SasataniLab/wpt-devkit/hardware/kicad/WPT-RX/Project Outputs for WPT-01-RECEIVER/Figure PNG/WPT-02-RECEIVER-BOTTOM_2020-03-09.png

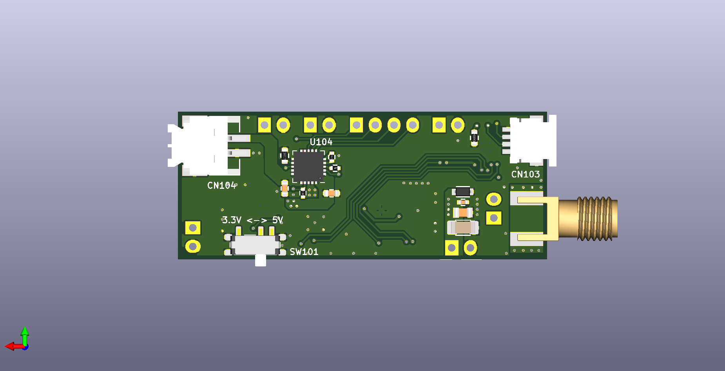
hardware/kicad/WPT-RX/Project Outputs for WPT-01-RECEIVER/Figure PNG/WPT-02-RECEIVER-BOTTOM_2020-03-09.png
