SasataniLab/wpt-devkit/hardware/kicad/WPT-RX/Project Outputs for WPT-01-RECEIVER/BOM/Bill of Materials - WPT-02-RECEIVER_2020-03-09.xlsx

Source: | E:\Dropbox\dev\prj\commissioned\University of Tokyo\WPT\electric\kicad\WPT-02-RECEIVER\WPT-02-RECEIVER.sch
Date: | 09/03/2020 07:57:30
Tool: | Eeschema (5.1.5)-3
Generator: | E:\Dropbox\dev\prj\kicad-library/bom_csv_grouped_by_value_with_fp.py
Component Count: | 84
Mount | Comment | Description | Designator | Footprint | Manufacturer | Manufacturer Part Number | Qnty | Qty for 25Units | Retailer
Yes | 0.022u/50(X7R) | CAP CER 0.022UF 50V X7R 0402 | C101, | murata:GRM15 | Murata Electronics | GRM155R71H223KA12D | 1 | 25
Yes | 10u/50(X5R) | CAP CER 10UF 50V X5R 1206 | C102, C107, | murata:GRM31 | Samsung Electro-Mechanics | CL31A106KBHNNNE | 2 | 50
Yes | 0.1u/50(X7R) | CAP CER 0.1UF 50V X7R 0402 | C103, C104, C116, C119, | murata:GRM15 | Murata Electronics | GCM155R71H104KE02D | 4 | 100
Yes | 1000p/50(C0G) | CAP CER 1000PF 50V 5% NP0 0402 | C105, | murata:GRM15 | Murata Electronics | GRM1555C1H102JA01D | 1 | 25
Yes | 0.1u/100(X7R) | CAP CER 0.1UF 100V X7R 0805 | C106, | murata:GRM21 | Murata Electronics | GCM21BR72A104KA37L | 1 | 25
Yes | 22u/16(X5R) | CAP CER 22UF 16V X5R 0805 | C108, C109, | murata:GRM21 | Samsung Electro-Mechanics | CL21A226MOCLRNC | 2 | 50
Yes | 10n/50(X7R) | CAP CER 10000PF 50V X7R 0402 | C110, | murata:GRM15 | Yageo | CC0402KRX7R9BB103 | 1 | 25
Yes | 10u/25(X5R) | CAP CER 10UF 25V 20% X5R 0603 | C111, | murata:GRM18 | Murata Electronics | GRM188R61E106MA73D | 1 | 25
Yes | 22u/10(X5R) | CAP CER 22UF 10V X5R 0603 | C112, C122, | murata:GRM18 | Murata Electronics | GRM188R61A226ME15D | 2 | 50
Yes | 68p/50(C0G) | CAP CER 68PF 50V C0G/NP0 0402 | C113, | murata:GRM15 | Murata Electronics | GCM1555C1H680JA16D | 1 | 25
Yes | 4.7u/16(X5R) | CAP CER 4.7UF 16V X5R 0603 | C117, C118, C120, | murata:GRM18 | Murata Electronics | GRM188R61C475KAAJD | 3 | 75
No | OPEN |  | C123, | murata:GRM18 |  |  | 1 | 25
No | CON-SMA-EDGE-S | CONN SMA JACK STR EDGE MNT | CN101, | RF_Solutions:CON-SMA-EDGE-S | RF Solutions | CON-SMA-EDGE-S | 1 | 25
No | ULO-PH409-1*2SF11 | CON HEADER 2 PIN THROUGHTHOLE 6.1/2.5/3mm HEIGHT | CN102, CN105, CN107, CN109, CN110, CN111, | ulo:ULO-PH409-1x2SX1 | ULO Electronic | ULO-PH409-1x2SX1 | 6 | 150
Yes | SM04B-SRSS-TB(LF)(SN) | CONN HEADER SH 4POS SIDE 1MM TIN | CN103, | Connectors_JST:SM04B-SRSS-TB | JST | SM04B-SRSS-TB(LF)(SN) | 1 | 25
Yes | S2B-PH-SM4-TB(LF)(SN) | CONN HEADER PH SIDE 2POS 2MM SMD | CN104, | Connectors_JST:S2B-PH-SM4-TB | JST | S2B-PH-SM4-TB(LF)(SN) | 1 | 25
No | ULO-PH409-1*4SF11 | CON HEADER 4 PIN THROUGHTHOLE 6.1/2.5/3mm HEIGHT | CN112, | ulo:ULO-PH409-1x4SX1 | ULO Electric | ULO-PH409-1*4SF11 | 1 | 25
Yes | PMEG6010AESBYL | DIODE SCHOTTKY 60V 1A DSN1006-2 | D101, D102, D105, D106, | Diodes_SMD:SOD-993_Nexperia | Nexperia | PMEG6010AESBYL | 4 | 100
Yes | S210FA | DIODE SCHOTTKY 100V 2A SOD123FA | D103, | Diodes_SMD:SOD-123FA_OnSemi | ON Semiconductor | S210FA | 1 | 25
Yes | MM3Z39VT1G | DIODE ZENER 39V 300MW SOD323 | D104, | Diodes_SMD:SOD-323 | ON Semiconductor | MM3Z39VT1G | 1 | 25
Yes | BLM18PG330SN1D | FERRITE CHIP 33 OHM 3000MA 0603 | FB101, FB102, | murata:BLM18 | Murata Electronics | BLM18PG330SN1D | 2 | 50
Yes | NR5040T4R7N | FIXED IND 4.7UH 3.1A 37.7 MOHM | L101, | taiyo-yuden:NR5040 | Taiyo Yuden | NR5040T4R7N | 1 | 25
Yes | DFE252012P-3R3M=P2 | FIXED IND 3.3UH 2.3A 140 MOHM | L102, | murata:DFE252012C | Murata Electronics | DFE252012P | 1 | 25
Yes | 82kF | RES SMD 82K OHM 1% 1/16W 0402 | R101, | yageo:R_0402 | Yageo | RC0402FR-0782KL | 1 | 25
Yes | 18kF | RES SMD 18K OHM 5% 1/16W 0402 | R102, | yageo:R_0402 | Yageo | RC0402FR-0718KL | 1 | 25
Yes | 27mF(1/4W) | RES 0.027 OHM 1% 1/4W 1206 3216Metric | R103, R107, | yageo:R_1206 | Yageo | RL1206FR-070R027L | 2 | 50
Yes | 10kF | RES SMD 10K OHM 1% 1/16W 0402 | R104, R116, | yageo:R_0402 | Yageo | RC0402FR-0710KL | 2 | 50
No | OPEN |  | R105, R106, R108, R114, R119, | yageo:R_0402 |  |  | 5 | 125
Yes | 750kF | RES SMD 750K OHM 1% 1/16W 0402 | R109, | yageo:R_0402 | Yageo | RC0402FR-07750KL | 1 | 25
Yes | 91kF | RES SMD 91K OHM 1% 1/16W 0402 | R110, | yageo:R_0402 | Yageo | RC0402FR-0791KL | 1 | 25
Yes | 820kF | RES SMD 820K OHM 1% 1/16W 0402 | R111, | yageo:R_0402 | Yageo | RC0402FR-07820KL | 1 | 25
Yes | 0 | RES SMD 0.0OHM JUMPER 1/16W 0402 | R113, R115, | yageo:R_0402 | Yageo | RC0402FR-070RL | 2 | 50
Yes | 0 | RES SMD 0.0OHM JUMPER 1/10W 0603 | R112, R117, | yageo:R_0603 | Yageo | RC0603FR-070RL | 2 | 50
Yes | NCP15XH103F03RC | THERMISTOR 10K OHM NTC 0402 SMD | R118, | murata:NTC_0402 | Murata Electronics | NCP15XH103F03RC | 1 | 25
Yes | 100kF | RES SMD 100K OHM 1% 1/16W 0402 | R120, R126, | yageo:R_0402 | Yageo | RC0402FR-07100KL | 2 | 50
Yes | 143kF | RES SMD 143K OHM 1% 1/16W 0402 | R121, | yageo:R_0402 | Yageo | RC0402FR-07143KL | 1 | 25
Yes | 100kF | RES SMD 100K OHM 1% 1/10W 0603 | R123, | yageo:R_0603 | Yageo | RC0603FR-07100KL | 1 | 25
Yes | 10kF | RES SMD 10K OHM 1% 1/10W 0603 | R124, | yageo:R_0603 | Yageo | RC0603FR-0710KL | 1 | 25
Yes | CUS-12TB | SWITCH SLIDE SPDT 300MA 4V | SW101, | Nidec_Copal_Electronics:CUS-12TB | Nidec Copal Electronics | CUS-12TB | 1 | 25
No | TP1.0 | TEST POINT 1mm | TP101, TP102, TP103, TP104, TP105, TP106, TP107, TP108, TP109, TP110, TP111, TP112, TP113, TP114, | TestPoint:TP_1mm |  |  | 14 | 350
Yes | TS30042-M000QFNR | IC REG BUCK ADJ 2A SYNC 16-VQFN | U101, | Housings_DFN_QFN:QFN-16-1EP_3x3mm_Pitch0.5mm_Semtech | Semtech | TS30042-M000QFNR | 1 | 25
Yes | MP2155GQ-Z | IC REG BCK BST 3.3V/ADJ 10QFN | U102, | Housings_DFN_QFN:DFN-10-1EP_3x3mm_Pitch0.5mm_MPS | Monolithic Power Systems Inc. | MP2155GQ-Z | 1 | 25
Yes | PAC1720-1-AIA-TR | IC CURRENT SENSE MON DUAL 10VDFN | U103, | Housings_DFN_QFN:DFN-10-1EP_3x3mm_Pitch0.5mm_microchip_9Q | microchip | PAC1720-1-AIA-TR | 1 | 25
Yes | MCP73871T-1CCI_ML | USB/AC BATTERY CHARGER 4.1V 6H Timer 3.1V LBO | U104, | Housings_DFN_QFN:QFN-20-1EP_4x4mm_Pitch0.5mm_microchip_ML | microchip | MCP73871T-1CCI/ML | 1 | 25
Yes | CG0402MLC-3.3LG | VARISTOR 3.3V 0402 | VD101, | bourns:CG0402 | Bourns Inc. | CG0402MLC-3.3LG | 1 | 25
