SasataniLab/wpt-devkit/hardware/kicad/WPT-TX/WPT-01-TRANSMITTER.csv

Reference | Qty | Value | DNP | Exclude from BOM | Exclude from Board | Exclude from Simulation | Exclude from Position Files | Footprint | Datasheet
C201,C202,C212,C218,C220,C222 | 6 | 10u/50(X7R) |  |  |  |  | ${EXCLUDE_FROM_POS_FILES} | murata:GRM31 | http://www.samsungsem.com/kr/support/product-search/mlcc/CL31A106KBHNNNE.jsp
C203,C204,C207,C208,C209,C210,C211,C301,C303,C311,C312,C317,C319,C321,C328,C329,C334 | 17 | 0.1u/50(X7R) |  |  |  |  | ${EXCLUDE_FROM_POS_FILES} | murata:GRM15 | http://www.murata.com/~/media/webrenewal/support/library/catalog/products/capacitor/mlcc/c02e.ashx,http://www.murata.com/~/media/webrenewal/support/library/ca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
C205,C206 | 2 | 0.022u/50(X7R) |  |  |  |  | ${EXCLUDE_FROM_POS_FILES} | murata:GRM15 | http://www.murata.com/~/media/webrenewal/support/library/catalog/products/capacitor/mlcc/c02e.ashx?la=en
C213,C214,C314,C335 | 4 | 1u/50(X7R) |  |  |  |  | ${EXCLUDE_FROM_POS_FILES} | murata:GRM21 | http://www.samsungsem.com/kr/support/product-search/mlcc/CL21B105KBFNNNG.jsp
C215,C216 | 2 | 10u/25(X5R) |  |  |  |  | ${EXCLUDE_FROM_POS_FILES} | murata:GRM18 | http://www.murata.com/~/media/webrenewal/support/library/catalog/products/capacitor/mlcc/c02e.ashx
C217,C219 | 2 | 22u/16(X5R) |  |  |  |  | ${EXCLUDE_FROM_POS_FILES} | murata:GRM21 | http://www.samsungsem.com/kr/support/product-search/mlcc/CL21B105KBFNNNG.jsp
C221,C223 | 2 | 10n/50(X7R) |  |  |  |  | ${EXCLUDE_FROM_POS_FILES} | murata:GRM15 | http://www.yageo.com/documents/recent/UPY-GPHC_X7R_6.3V-to-50V_18.pdf
C302,C304,C318,C320 | 4 | 22n/25(X7R) |  |  |  |  | ${EXCLUDE_FROM_POS_FILES} | murata:GRM15 | http://www.yageo.com/documents/recent/UPY-GPHC_X7R_6.3V-to-50V_18.pdf
C305,C306,C307,C308,C322,C323,C324,C325 | 8 | 10n/100(X7R) |  |  |  |  | ${EXCLUDE_FROM_POS_FILES} | murata:GRM18 | http://www.samsungsem.com/kr/support/product-search/mlcc/CL10B103KC8WPNC.jsp
C309,C310,C326,C327 | 4 | 2.2u/100(X7R) |  |  |  |  | ${EXCLUDE_FROM_POS_FILES} | murata:GRM32 | http://www.samsungsem.com/kr/support/product-search/mlcc/CL32B225KCJZW6E.jsp
C313,C331 | 2 | 4.7u/16(X5R) |  |  |  |  | ${EXCLUDE_FROM_POS_FILES} | murata:GRM15 | http://www.samsungsem.com/kr/support/library/product-catalog/mlcc.jsp
C315,C316,C336,C337 | 4 | 22p/50(C0G) |  |  |  |  | ${EXCLUDE_FROM_POS_FILES} | murata:GRM15 | http://www.murata.com/~/media/webrenewal/support/library/catalog/products/capacitor/mlcc/c02e.ashx
C330,C332,C333 | 3 | OPEN |  |  |  |  | ${EXCLUDE_FROM_POS_FILES} | murata:GRM15 | http://www.murata.com/~/media/webrenewal/support/library/catalog/products/capacitor/mlcc/c02e.ashx,http://www.yageo.com/documents/recent/UPY-GPHC_X7R_6.3V-to-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
CN201,CN202,CN204,CN205 | 4 | ULO-FH411-1*15SF11 |  |  |  |  | ${EXCLUDE_FROM_POS_FILES} | ulo:ULO-FH411-1x15SX1
CN203,CN207 | 2 | ULO-PH409-1*3SF11 |  |  |  |  | ${EXCLUDE_FROM_POS_FILES} | ulo:ULO-PH409-1x3SX1 | http://www.ulogroup.com/upload/2013101815053045.pdf
CN206 | 1 | SM04B-SRSS-TB(LF)(SN) |  |  |  |  | ${EXCLUDE_FROM_POS_FILES} | Connectors_JST:SM04B-SRSS-TB | http://www.jst-mfg.com/product/pdf/eng/eSH.pdf
CN208,CN209,CN210,CN302,J202 | 5 | ULO-PH409-1*2SF11 |  |  |  |  | ${EXCLUDE_FROM_POS_FILES} | ulo:ULO-PH409-1x2SX1 | http://www.ulogroup.com/upload/2013101815053045.pdf
CN301 | 1 | CON-SMA-EDGE-S |  |  |  |  | ${EXCLUDE_FROM_POS_FILES} | RF_Solutions:CON-SMA-EDGE-S | https://media.digikey.com/pdf/Data%20Sheets/RF%20Solutions%20PDFs/CON-SMA-EDGE.pdf
D201 | 1 | OSR5JA3Z74A |  |  |  |  | ${EXCLUDE_FROM_POS_FILES} | LED_THT:LED_D3.0mm | http://akizukidenshi.com/download/ds/optosupply/OSXXXX3Z74A_VER_A1.pdf
D202,D203 | 2 | S210FA |  |  |  |  | ${EXCLUDE_FROM_POS_FILES} | Diodes_SMD:SOD-123FA_OnSemi | https://www.onsemi.com/pub/Collateral/SS29FA-D.pdf
D301,D307 | 2 | MM3Z5V1T1G |  |  |  |  | ${EXCLUDE_FROM_POS_FILES} | SOD-323 | http://www.onsemi.com/pub/Collateral/MM3Z2V4T1-D.PDF
D302,D308 | 2 | BAT54KFILM |  |  |  |  | ${EXCLUDE_FROM_POS_FILES} | Diodes_SMD:SOD-523F_STMicroelectronics | http://www.st.com/content/ccc/resource/technical/document/datasheet/07/50/54/f2/0d/ba/4a/79/CD00001322.pdf/files/CD00001322.pdf/jcr:content/translations/en.CD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
D303,D304,D305,D306,D309,D310,D311,D312 | 8 | SDM03U40-7 |  |  |  |  | ${EXCLUDE_FROM_POS_FILES} | Diodes_SMD:SOD-523F_Diodes | https://www.diodes.com/assets/Datasheets/ds30392.pdf
FB201,FB202 | 2 | BLM18PG330SN1D |  |  |  |  | ${EXCLUDE_FROM_POS_FILES} | murata:BLM18 | http://search.murata.co.jp/Ceramy/image/img/PDF/ENG/L0110S0100BLM18P.pdf
J201 | 1 | 54-00129 |  |  |  |  | ${EXCLUDE_FROM_POS_FILES} | Tensility_International_Corp:54-00129 | http://www.tensility.com/pdffiles/54-00129.pdf
L201,L202 | 2 | NR5040T4R7N |  |  |  |  | ${EXCLUDE_FROM_POS_FILES} | taiyo-yuden:NR5040 | https://ds.yuden.co.jp/TYCOMPAS/ut/detail?pn=NR5040T4R7N%20%20&u=M
L301,L302 | 2 | 390nH |  |  |  |  | ${EXCLUDE_FROM_POS_FILES} | Coilcraft:2929SQ | https://www.mouser.jp/datasheet/2/597/1515sq-270668.pdf
Q301,Q304 | 2 | EPC2038 |  |  |  |  | ${EXCLUDE_FROM_POS_FILES} | EPC:EPC2038 | http://epc-co.com/epc/Portals/0/epc/documents/datasheets/EPC2038_datasheet.pdf
Q302,Q303,Q305,Q306 | 4 | EPC2007C |  |  |  |  | ${EXCLUDE_FROM_POS_FILES} | EPC:EPC2007C | http://epc-co.com/epc/documents/datasheets/EPC2007C_datasheet.pdf
R201 | 1 | 75kF |  |  |  |  | ${EXCLUDE_FROM_POS_FILES} | yageo:R_0402 | http://www.yageo.com/NewPortal/yageodocoutput?fileName=/pdf/R-Chip/PYu-RC_Group_51_RoHS_L_3.pdf
R202 | 1 | 3.6kF |  |  |  |  | ${EXCLUDE_FROM_POS_FILES} | yageo:R_0402 | http://www.yageo.com/NewPortal/yageodocoutput?fileName=/pdf/R-Chip/PYu-RC_Group_51_RoHS_L_3.pdf
R203 | 1 | 0 |  |  |  |  | ${EXCLUDE_FROM_POS_FILES} | yageo:R_0603 | http://www.yageo.com/NewPortal/yageodocoutput?fileName=/pdf/R-Chip/PYu-RC_Group_51_RoHS_L_3.pdf
R204 | 1 | OPEN |  |  |  |  | ${EXCLUDE_FROM_POS_FILES} | yageo:R_0603 | http://www.yageo.com/NewPortal/yageodocoutput?fileName=/pdf/R-Chip/PYu-RC_Group_51_RoHS_L_3.pdf
R205,R226 | 2 | 27mF(1/4W) |  |  |  |  | ${EXCLUDE_FROM_POS_FILES} | yageo:R_1206 | http://rohmfs.rohm.com/jp/products/databook/datasheet/passive/resistor/chip_resistor/mcr_g-j.pdf
R206,R207,R209,R212,R215,R216,R217,R218,R225,R234,R314 | 11 | 10kF |  |  |  |  | ${EXCLUDE_FROM_POS_FILES} | yageo:R_0402 | http://www.yageo.com/NewPortal/yageodocoutput?fileName=/pdf/R-Chip/PYu-RC_Group_51_RoHS_L_3.pdf
R208 | 1 | 68kF |  |  |  |  | ${EXCLUDE_FROM_POS_FILES} | yageo:R_0402 | http://www.yageo.com/NewPortal/yageodocoutput?fileName=/pdf/R-Chip/PYu-RC_Group_51_RoHS_L_3.pdf
R210 | 1 | 3.9kF |  |  |  |  | ${EXCLUDE_FROM_POS_FILES} | yageo:R_0402 | http://www.yageo.com/NewPortal/yageodocoutput?fileName=/pdf/R-Chip/PYu-RC_Group_51_RoHS_L_3.pdf
R211 | 1 | 100F |  |  |  |  | ${EXCLUDE_FROM_POS_FILES} | yageo:R_0402 | http://www.yageo.com/NewPortal/yageodocoutput?fileName=/pdf/R-Chip/PYu-RC_Group_51_RoHS_L_3.pdf
R213,R221,R222,R223,R224,R313 | 6 | 0 |  |  |  |  | ${EXCLUDE_FROM_POS_FILES} | yageo:R_0402 | http://www.yageo.com/NewPortal/yageodocoutput?fileName=/pdf/R-Chip/PYu-RC_Group_51_RoHS_L_3.pdf
R214 | 1 | 200kF |  |  |  |  | ${EXCLUDE_FROM_POS_FILES} | yageo:R_0402 | http://www.yageo.com/NewPortal/yageodocoutput?fileName=/pdf/R-Chip/PYu-RC_Group_51_RoHS_L_3.pdf
R219,R220,R312 | 3 | OPEN |  |  |  |  | ${EXCLUDE_FROM_POS_FILES} | yageo:R_0402 | http://www.yageo.com/NewPortal/yageodocoutput?fileName=/pdf/R-Chip/PYu-RC_Group_51_RoHS_L_3.pdf
R301,R308 | 2 | 4.7J(1/10W) |  |  |  |  | ${EXCLUDE_FROM_POS_FILES} | yageo:R_0402 | https://industrial.panasonic.com/cdbs/www-data/pdf/RDA0000/AOA0000C301.pdf
R302,R309 | 2 | 2.7kF |  |  |  |  | ${EXCLUDE_FROM_POS_FILES} | yageo:R_0402 | http://www.yageo.com/NewPortal/yageodocoutput?fileName=/pdf/R-Chip/PYu-RC_Group_51_RoHS_L_3.pdf
R303,R310 | 2 | 20F |  |  |  |  | ${EXCLUDE_FROM_POS_FILES} | yageo:R_0402 | http://www.yageo.com/NewPortal/yageodocoutput?fileName=/pdf/R-Chip/PYu-RC_Group_51_RoHS_L_3.pdf
R304,R306,R311,R316 | 4 | 2.2F |  |  |  |  | ${EXCLUDE_FROM_POS_FILES} | yageo:R_0402 | http://www.yageo.com/NewPortal/yageodocoutput?fileName=/pdf/R-Chip/PYu-RC_Group_51_RoHS_L_3.pdf
R305,R315 | 2 | 470F |  |  |  |  | ${EXCLUDE_FROM_POS_FILES} | yageo:R_0603 | http://www.yageo.com/NewPortal/yageodocoutput?fileName=/pdf/R-Chip/PYu-RC_Group_51_RoHS_L_3.pdf
R307,R318 | 2 | 390F |  |  |  |  | ${EXCLUDE_FROM_POS_FILES} | yageo:R_0603 | http://www.yageo.com/NewPortal/yageodocoutput?fileName=/pdf/R-Chip/PYu-RC_Group_51_RoHS_L_3.pdf
TP201,TP202,TP203,TP204,TP205,TP207,TP208,TP211,TP216,TP219,TP221,TP222 | 12 | TP1.0 |  |  |  |  | ${EXCLUDE_FROM_POS_FILES} | TestPoint:TP_1mm
TP206,TP209,TP210,TP212,TP213,TP214,TP215,TP217,TP218,TP220,TP223,TP224,TP225 | 13 | TEST-1 |  |  |  |  | ${EXCLUDE_FROM_POS_FILES} | TestPoint:PTH_1mm | http://akizukidenshi.com/download/ds/kangyang/TEST-1H.PDF
U201,U207 | 2 | TS30042-M000QFNR |  |  |  |  | ${EXCLUDE_FROM_POS_FILES} | Housings_DFN_QFN:QFN-16-1EP_3x3mm_Pitch0.5mm_Semtech | https://semtech.my.salesforce.com/sfc/dist/version/download/?oid=00DE0000000JelG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
U202 | 1 | PCA9306DCUR |  |  |  |  | ${EXCLUDE_FROM_POS_FILES} | Housings_SSOP:Texas_S-PDSO-G8 | http://www.ti.com/lit/ds/symlink/pca9306.pdf
U203 | 1 | PAC1720-1-AIA-TR |  |  |  |  | ${EXCLUDE_FROM_POS_FILES} | Housings_DFN_QFN:DFN-10-1EP_3x3mm_Pitch0.5mm_microchip_9Q | http://ww1.microchip.com/downloads/en/DeviceDoc/20005386B.pdf
U204 | 1 | MCP45HV51-104E_ST |  |  |  |  | ${EXCLUDE_FROM_POS_FILES} | Housings_SSOP:TSSOP-14_4.4x5mm_P0.65mm | http://www.microchip.com/mymicrochip/filehandler.aspx?ddocname=en569827
U205 | 1 | NCP1117LPST50T3G |  |  |  |  | ${EXCLUDE_FROM_POS_FILES} | TO_SOT_Packages_SMD:SOT-223-3_TabPin2 | http://www.onsemi.com/pub/Collateral/NCP1117LP-D.PDF
U206 | 1 | MIC5504-3.3YM5-TR |  |  |  |  | ${EXCLUDE_FROM_POS_FILES} | TO_SOT_Packages_SMD:microchip_SOT23-5LD-PL-1 | http://www.microchip.com/mymicrochip/filehandler.aspx?ddocname=en580292
U301,U307 | 2 | 74LVC1G34SE-7 |  |  |  |  | ${EXCLUDE_FROM_POS_FILES} | TO_SOT_Packages_SMD:SOT-353_SC-70-5_Diodes | https://www.diodes.com/assets/Datasheets/74LVC1G17.pdf
U302,U305 | 2 | LM5113QDPRRQ1 |  |  |  |  | ${EXCLUDE_FROM_POS_FILES} | Package_SON:Texas_S-PWSON-N10_ThermalVias | http://www.ti.com/lit/ds/symlink/lm5113-q1.pdf
U303,U304 | 2 | 74LVC1G04SE-7 |  |  |  |  | ${EXCLUDE_FROM_POS_FILES} | TO_SOT_Packages_SMD:SOT-353_SC-70-5_Diodes | https://www.diodes.com/assets/Datasheets/74LVC1G04.pdf
U306 | 1 | SI5351A-B-GTR |  |  |  |  | ${EXCLUDE_FROM_POS_FILES} | Housings_SSOP:Siliconlabs_MSOP-10_3x3mm_Pitch0.5mm | https://www.silabs.com/documents/public/data-sheets/Si5351-B.pdf
X301 | 1 | FA-238_25.0000MB-K3 |  |  |  |  | ${EXCLUDE_FROM_POS_FILES} | epson:FA-238 | https://support.epson.biz/td/api/doc_check.php?dl=brief_FA-238&lang=en
