SasataniLab/wpt-devkit/hardware/kicad/WPT-RX/Project Outputs for WPT-01-RECEIVER/Export STEP/WPT-02-RECEIVER_2020-03-09.step

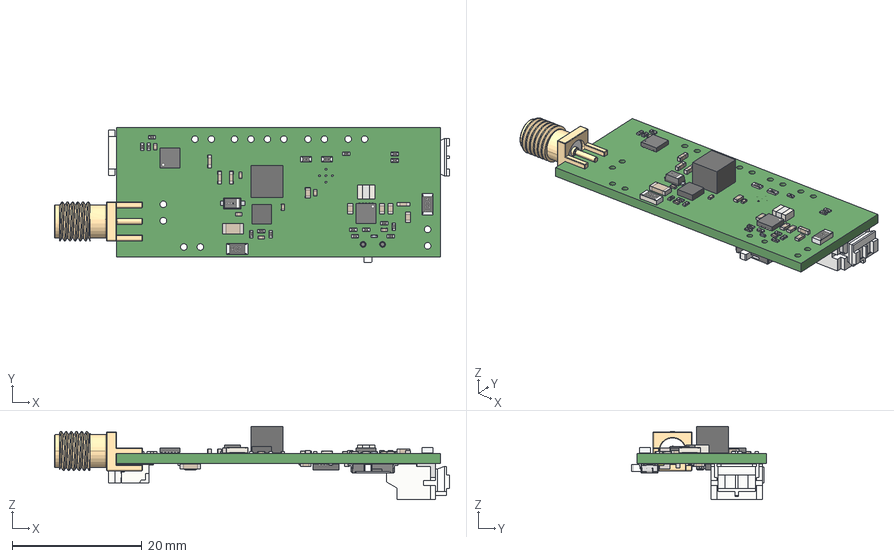
[picture p3: CAD file, 2022-04-14]
hardware/kicad/WPT-RX/Project Outputs for WPT-01-RECEIVER/Export STEP/WPT-02-RECEIVER_2020-03-09.step
61.0 x 20.9 x 11.3 mm
