SasataniLab/wpt-devkit/(list of files, cad)

Other CAD files:
hardware/kicad/WPT-TX/Project Output for WPT-01-TRANSMITTER/Export STEP/WPT-01-TRANSMITTER_200222.step
