SasataniLab/wpt-devkit/hardware/kicad/WPT-RX/Project Outputs for WPT-01-RECEIVER/Schematic PDF/WPT-02-RECEIVER_SCH_2020-03-09.pdf

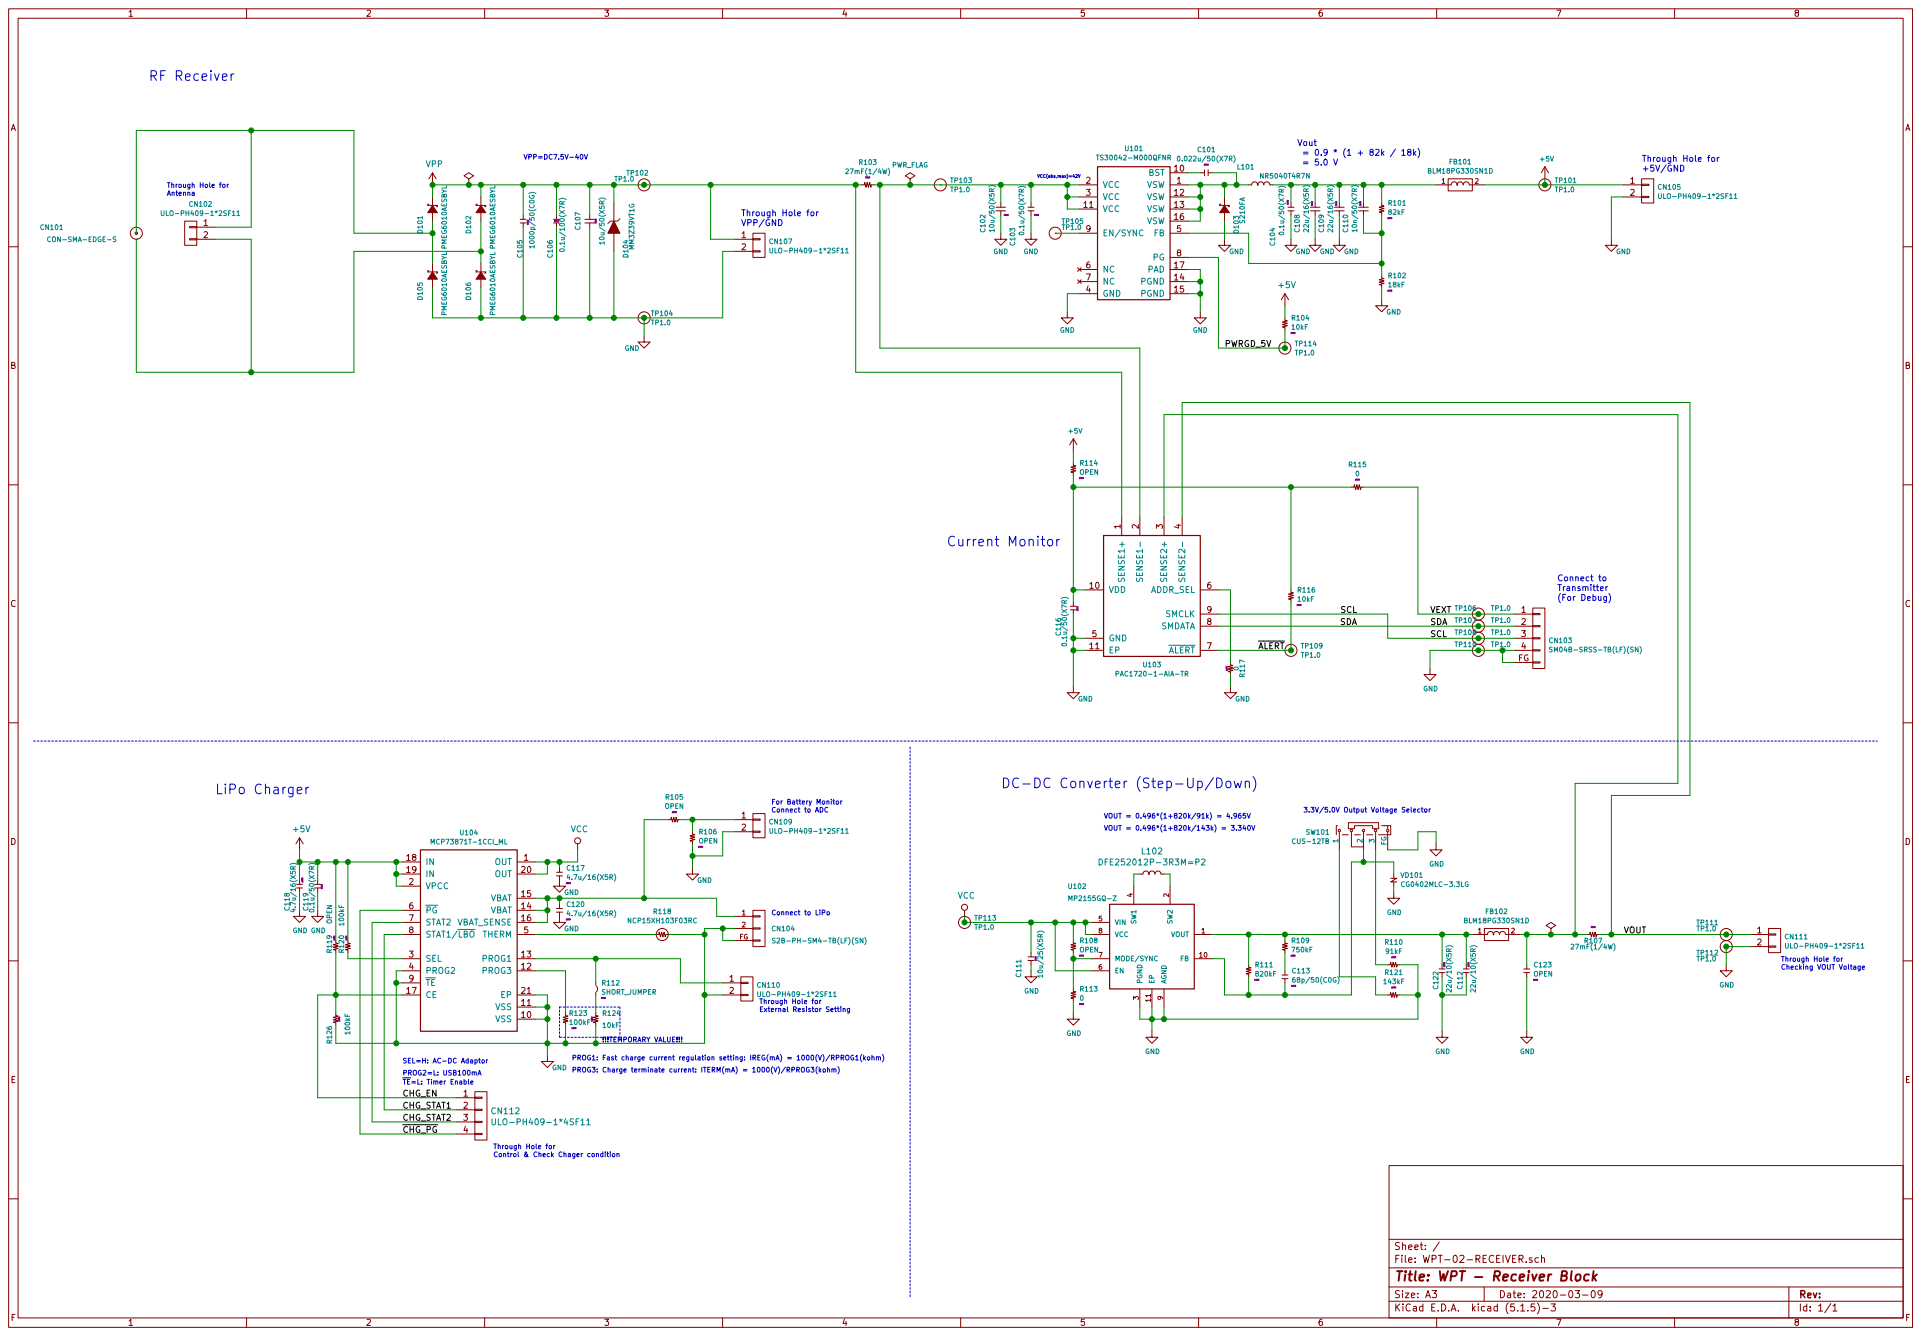
[picture p4: page 1]

Through Hole for +5V/GND RF Receiver

Through Hole for Antenna

Through Hole for VPP/GND

3 SENSE2- 4 GND 5 ADDR_SEL 6 ALERT 7 SMDATA 8 SMCLK 9 U103 PAC1720-1-AIA-TR GND SDA CHG_STAT1

CN103 SM04B-SRSS-TB(LF)(SN) R114 OPEN

PROG3: Charge terminate current: ITERM(mA) = 1000(V)/RPROG3(kohm) PROG1: Fast charge current regulation setting: IREG(mA) = 1000(V)/RPROG1(kohm) LiPo Charger

Through Hole for Checking VOUT Voltage DC-DC Converter (Step-Up/Down)

For Battery Monitor Connect to ADC
VOUT = 0.496*(1+820k/91k) = 4.965V Connect to LiPo

4 VIN 5 EN 6 MODE/SYNC 7 VCC 8 AGND

!!!TEMPORARY VALUE!!! SEL=H: AC-DC Adaptor

PROG2=L: USB100mA TE=L: Timer Enable

Through Hole for Control & Check Chager condition

Id: 1/1 Title: WPT - Receiver Block
