SasataniLab/wpt-devkit/hardware/kicad/WPT-TX/Project Output for WPT-01-TRANSMITTER/Schematic PDF/WPT-01-TRANSMITTER_2020-02-22.pdf

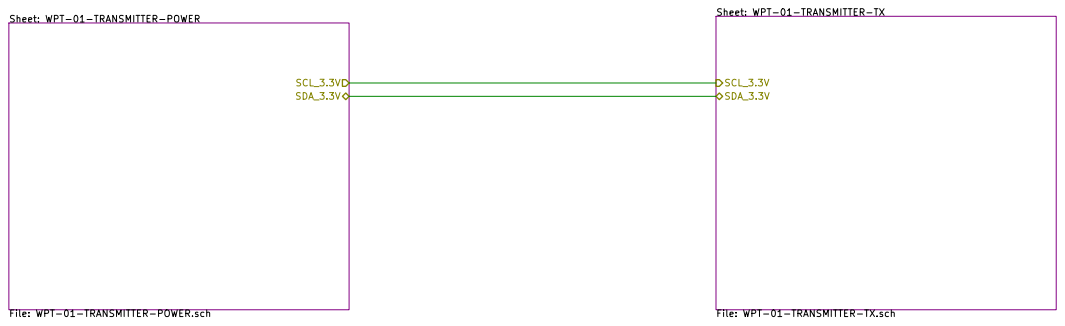
[picture p5: page 1]

Sheet: WPT-01-TRANSMITTER-TX

Sheet: WPT-01-TRANSMITTER-POWER

File: WPT-01-TRANSMITTER-TX.sch SCL_3.3V
SDA_3.3V

File: WPT-01-TRANSMITTER.sch Sheet: /
Id: 1/3 Title: WPT - Transmitter Block

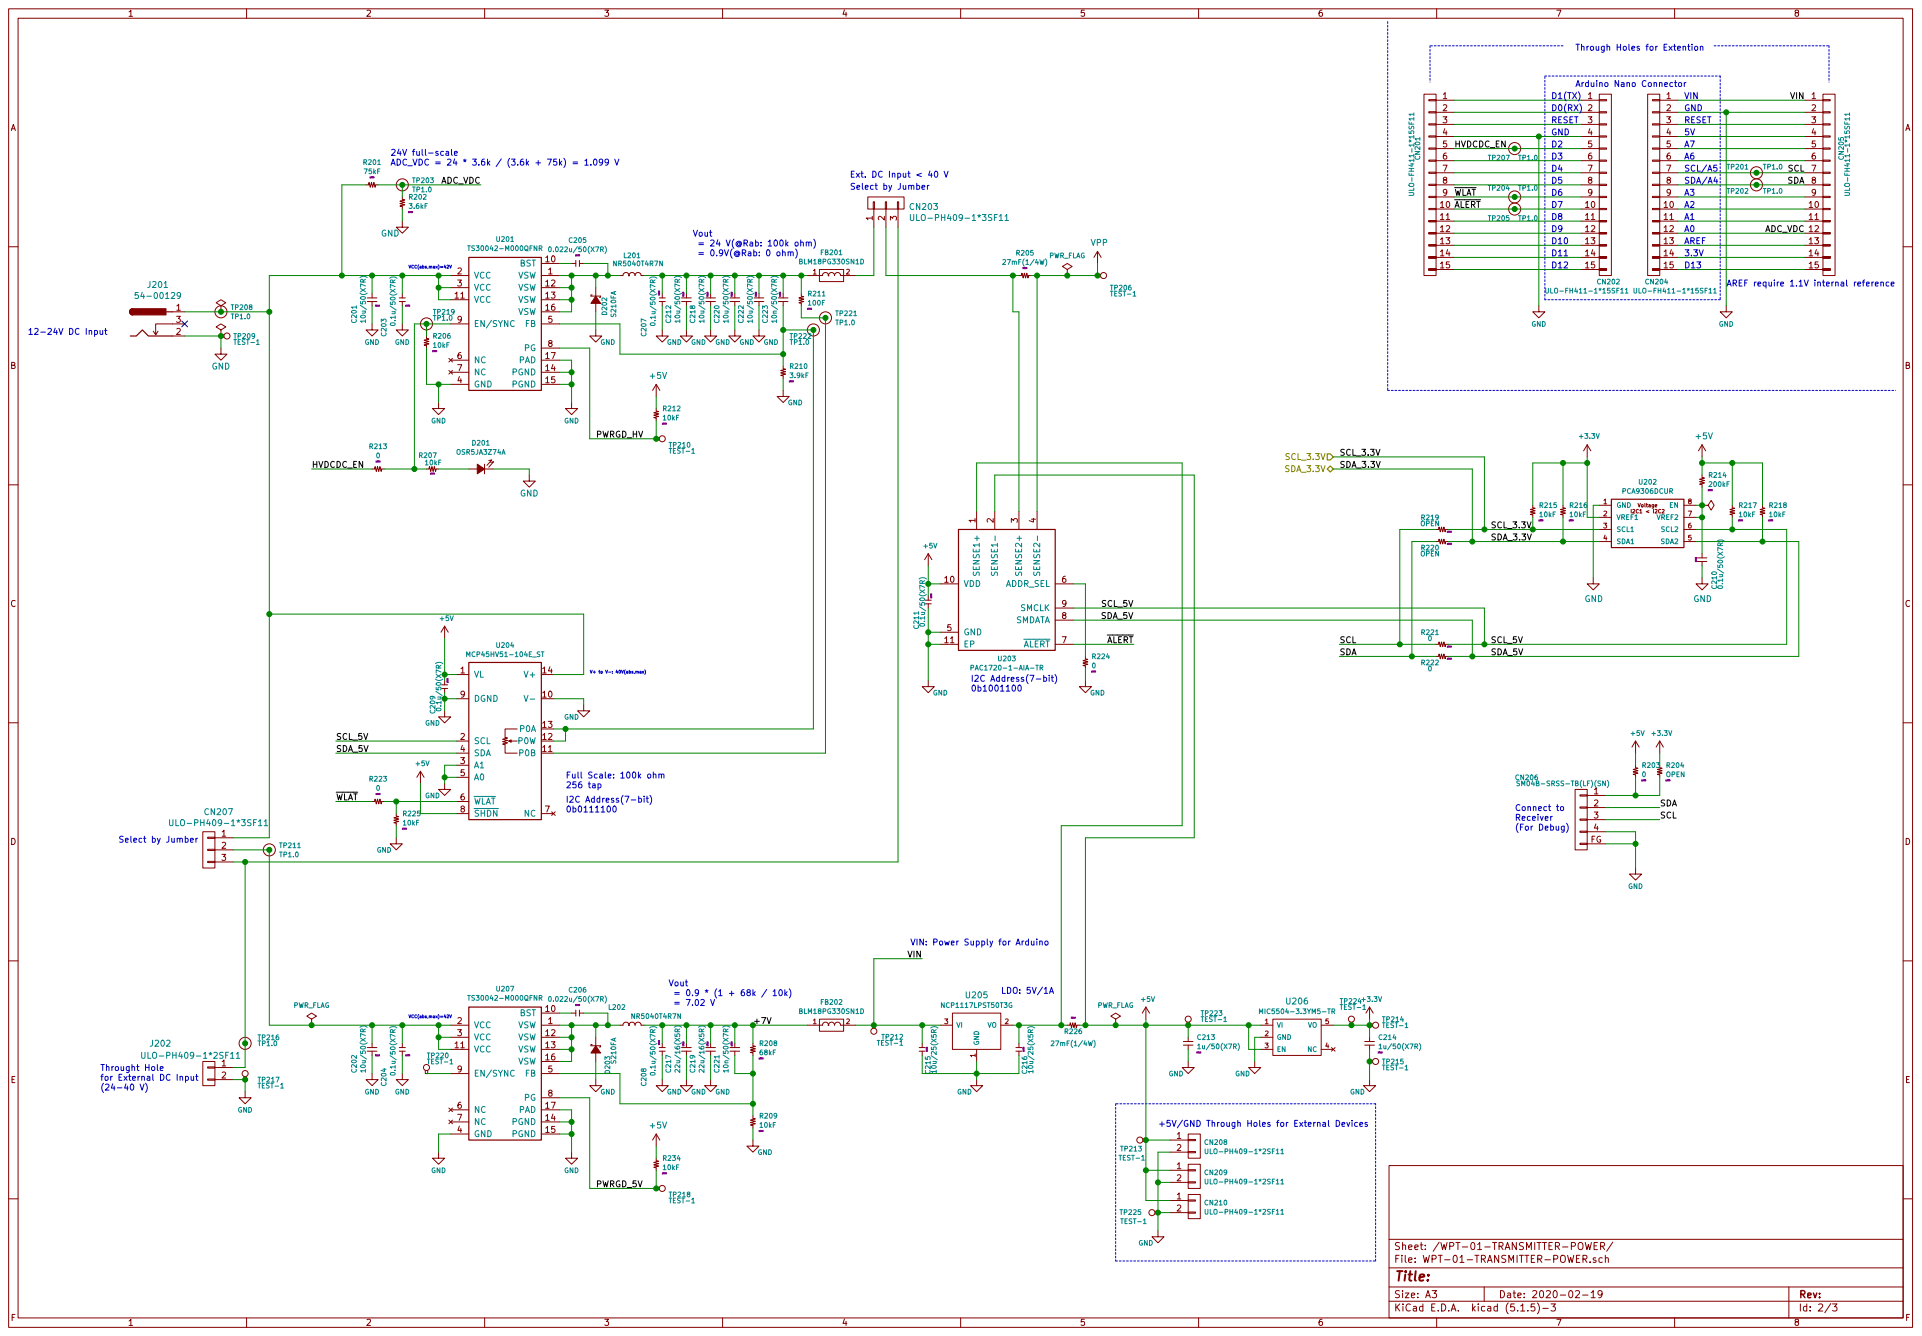
[picture p6: page 2]

Through Holes for Extention
SDA_3.3V HVDCDC_EN

2 | D0(RX) 2

10 | D7 10
11 | 11
12 | 12
13 | 13
14 | 14
15 | 15

3 SENSE2- 4 GND 5 ADDR_SEL 6 ALERT 7 SMDATA 8 SMCLK 9 U203 PAC1720-1-AIA-TR GND

I2C Address(7-bit) 0b0111100 Throught Hole

VIN: Power Supply for Arduino
VIN

for External DC Input

+5V/GND Through Holes for External Devices

Id: 2/3 Title: File: WPT-01-TRANSMITTER-POWER.sch Sheet: /WPT-01-TRANSMITTER-POWER/

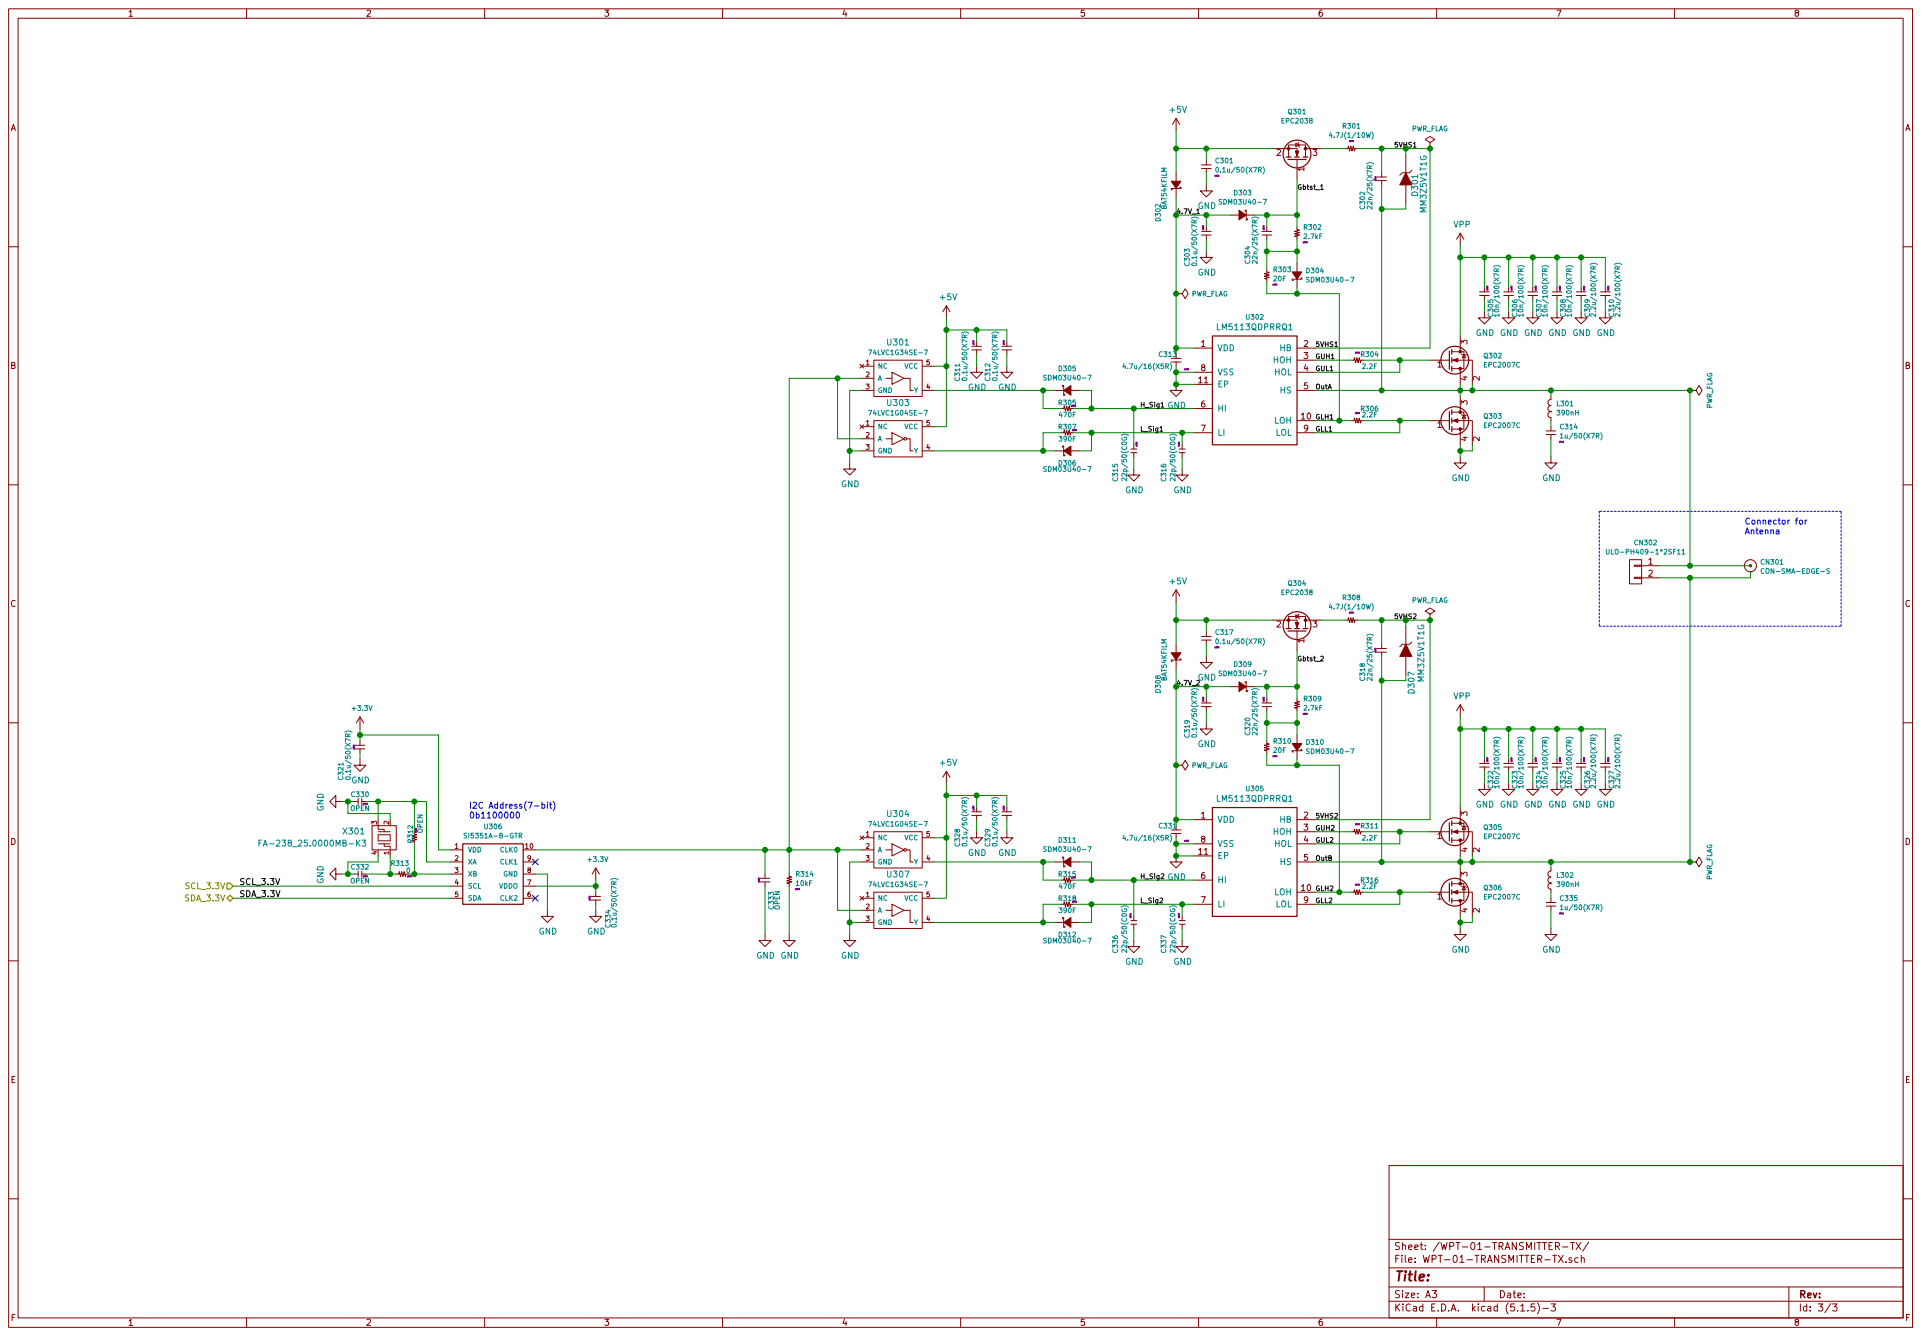
[picture p7: page 3]

Id: 3/3 Title: File: WPT-01-TRANSMITTER-TX.sch Sheet: /WPT-01-TRANSMITTER-TX/
