SasataniLab/wpt-devkit/hardware/kicad/WPT-RX/Project Outputs for WPT-01-RECEIVER/Assembly Drawing/WPT-02-RECEIVER_BottomAssemblyDrawing_2020-03-09.pdf

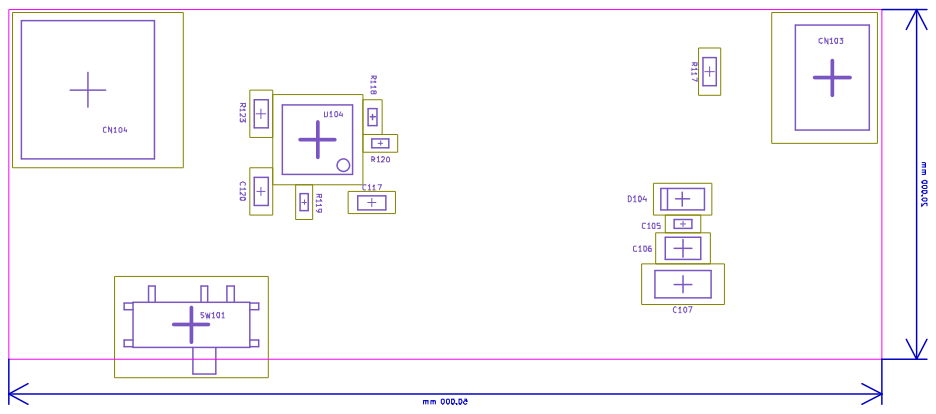
[picture p8: page 1]
