SasataniLab/wpt-devkit/hardware/kicad/WPT-RX/Project Outputs for WPT-01-RECEIVER/Assembly Drawing/WPT-02-RECEIVER_TopAssemblyDrawing_2020-03-09.pdf

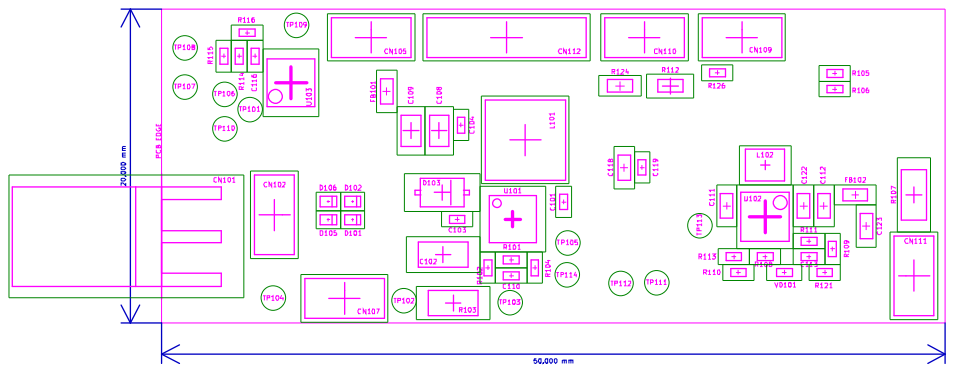
[picture p9: page 1]
