SasataniLab/wpt-devkit/hardware/kicad/WPT-TX/WPT-01-TRANSMITTER.kicad_pcb

## KiCad design hardware/kicad/WPT-TX/WPT-01-TRANSMITTER.kicad_pcb (2026-10-28)

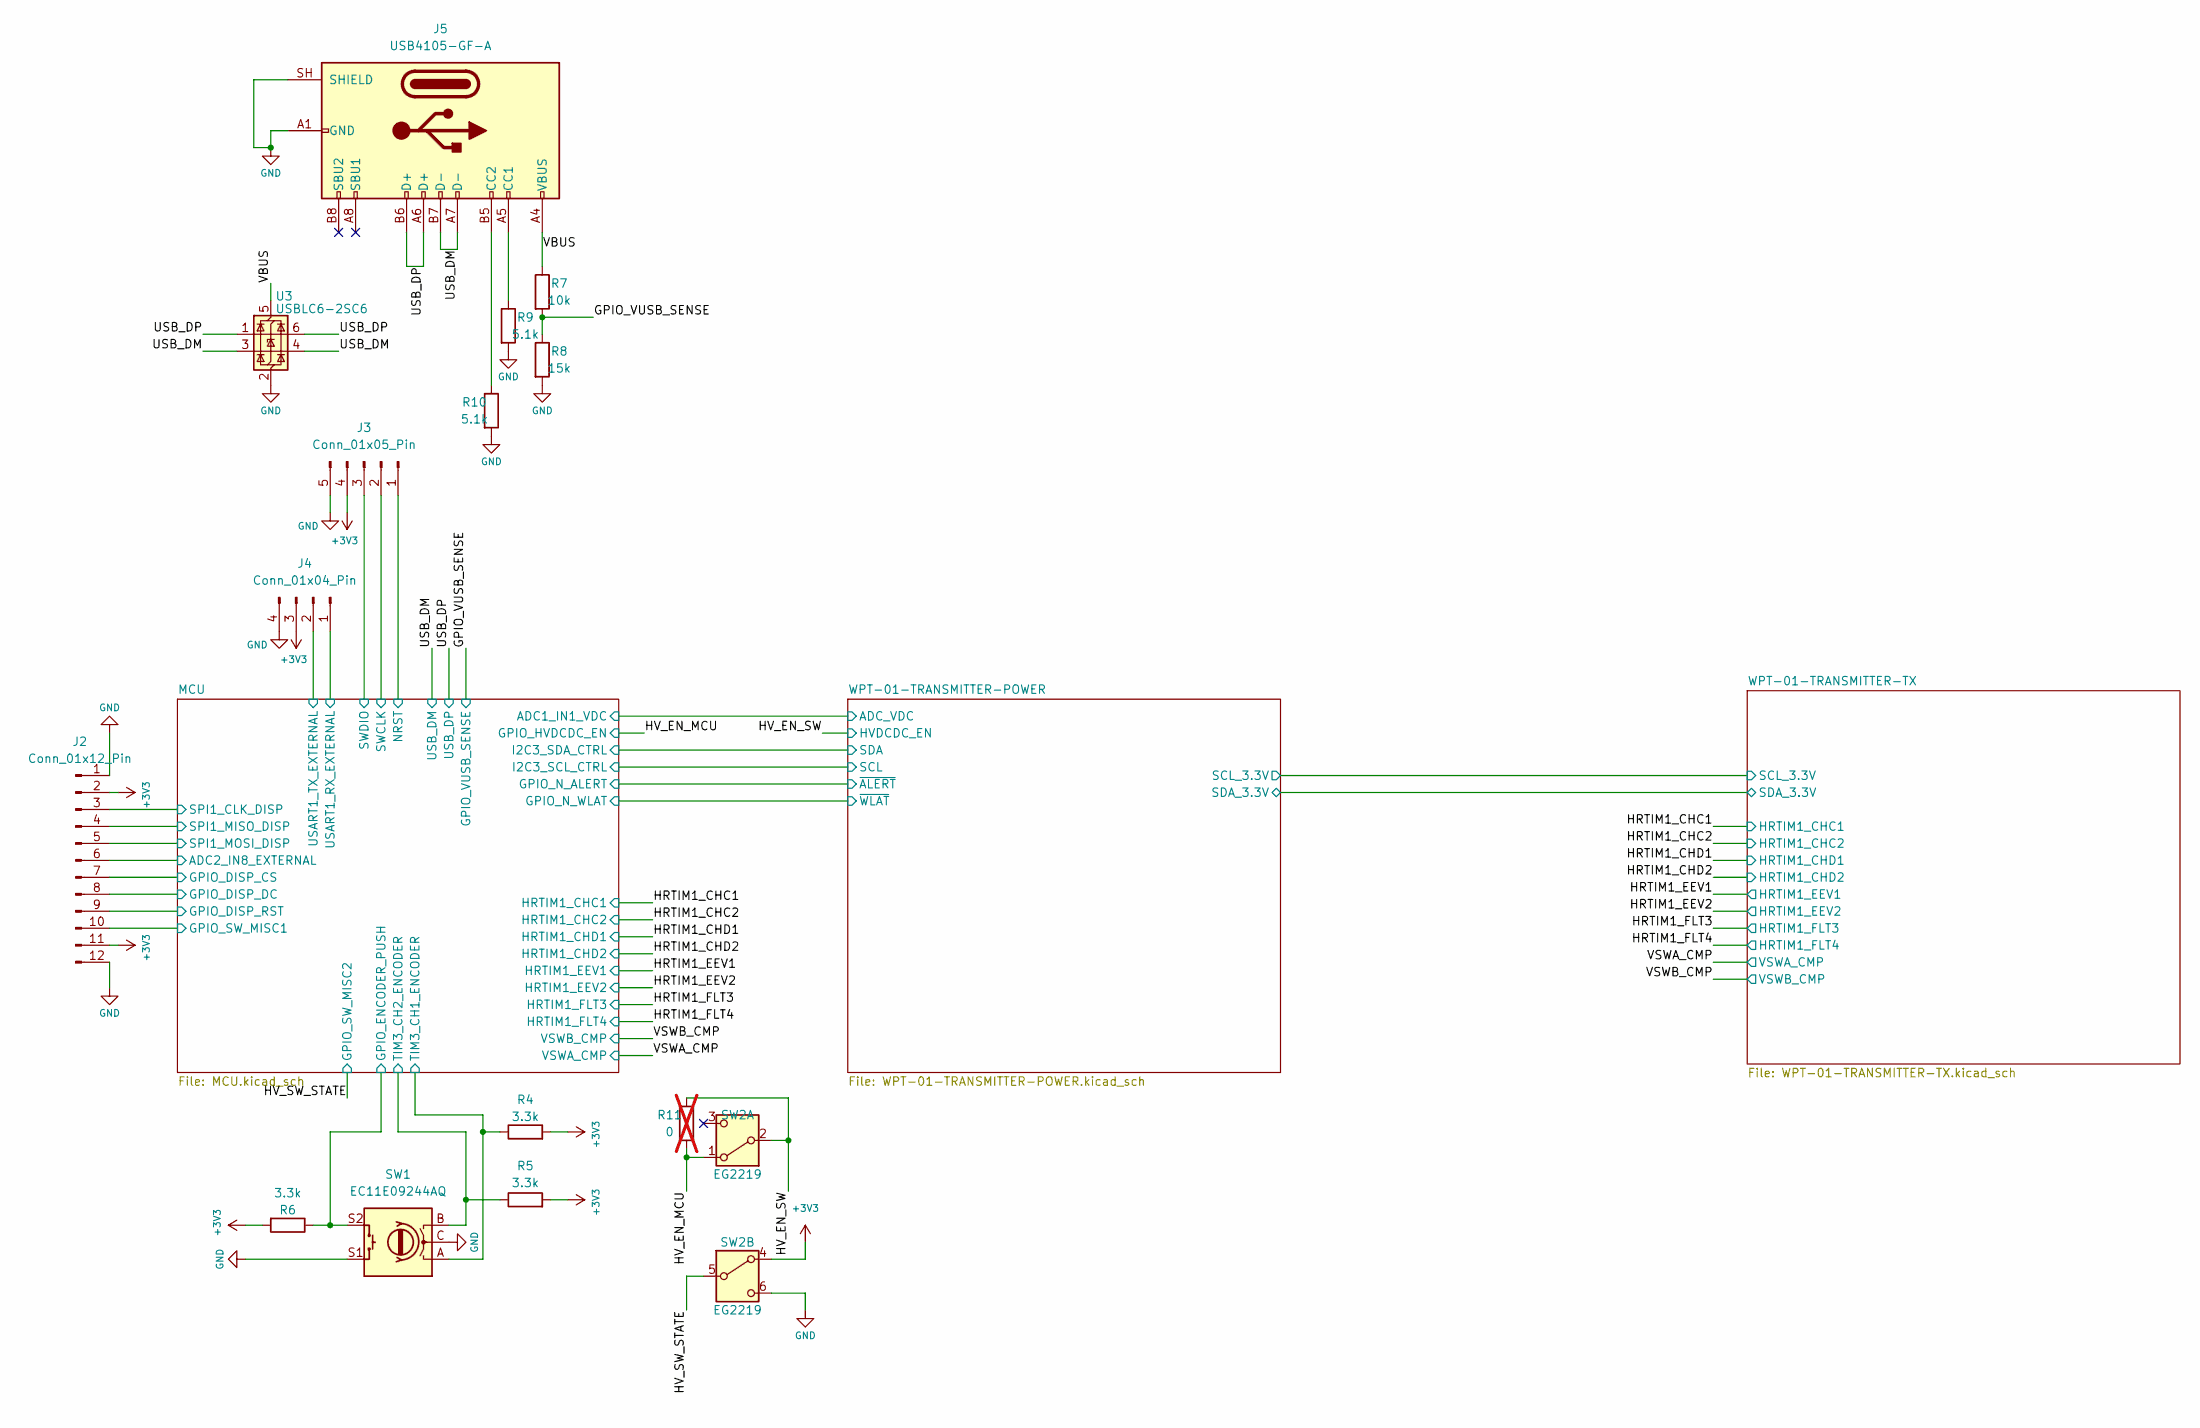
[picture p10: schematic WPT-01-TRANSMITTER.kicad_sch, WPT - Transmitter Block]

Parts:
J2: Conn_01x12_Pin; PinHeader_1x12_P2.54mm_Vertical
J3: Conn_01x05_Pin; PinHeader_1x05_P2.54mm_Vertical
J4: Conn_01x04_Pin; PinHeader_1x04_P2.54mm_Vertical
J5: USB4105-GF-A; USB_C_Receptacle_GCT_USB4105-xx-A_16P_TopMnt_Horizontal
R4, R5, R6: 3.3k; R_0402_1005Metric
R7: 10k; R_0402_1005Metric
R8: 15k; R_0402_1005Metric
R9, R10: 5.1k; R_0402_1005Metric
R11: 0; R_0402_1005Metric; not fitted
SW1: EC11E09244AQ; RotaryEncoder_Alps_EC11E-Switch_Vertical_H20mm
SW2: EG2219; SW_E-Switch_EG2219_DPDT_Angled
U3: USBLC6-2SC6; SOT-23-6

Connections:
+3V3: J2.2, J2.11, J3.4, J4.3, R4.2, R5.2, R6.2, SW2.4 (A); also elsewhere on the board
/GPIO_VUSB_SENSE: R7.2, R8.1; also elsewhere on the board
/HV_EN_MCU: R11.2, SW2.1 (A); also elsewhere on the board
/HV_EN_SW: R11.1, SW2.2 (B); also elsewhere on the board
/HV_SW_STATE: SW2.5 (B); also elsewhere on the board
/MCU/ADC2_IN8_EXTERNAL: J2.6; also elsewhere on the board
/MCU/GPIO_DISP_CS: J2.7; also elsewhere on the board
/MCU/GPIO_DISP_DC: J2.8; also elsewhere on the board
/MCU/GPIO_DISP_RST: J2.9; also elsewhere on the board
/MCU/GPIO_ENCODER_PUSH: R6.1, SW1.S2; also elsewhere on the board
/MCU/GPIO_SW_MISC1: J2.10; also elsewhere on the board
/MCU/NRST: J3.1; also elsewhere on the board
/MCU/SPI1_CLK_DISP: J2.3; also elsewhere on the board
/MCU/SPI1_MISO_DISP: J2.4; also elsewhere on the board
/MCU/SPI1_MOSI_DISP: J2.5; also elsewhere on the board
/MCU/SWCLK: J3.2; also elsewhere on the board
/MCU/SWDIO: J3.3; also elsewhere on the board
/MCU/TIM3_CH1_ENCODER: R4.1, SW1.A; also elsewhere on the board
/MCU/TIM3_CH2_ENCODER: R5.1, SW1.B; also elsewhere on the board
/MCU/USART1_RX_EXTERNAL: J4.1; also elsewhere on the board
/MCU/USART1_TX_EXTERNAL: J4.2; also elsewhere on the board
/USB_DM: J5.A7 (D-), J5.B7 (D-), U3.3 (I/O2), U3.4 (I/O2); also elsewhere on the board
/USB_DP: J5.A6 (D+), J5.B6 (D+), U3.1 (I/O1), U3.6 (I/O1); also elsewhere on the board
/VBUS: J5.A4 (VBUS), J5.A9 (VBUS), J5.B4 (VBUS), J5.B9 (VBUS), R7.1, U3.5 (VBUS)
GND: J2.1, J2.12, J3.5, J4.4, J5.A1 (GND), J5.A12 (GND), J5.B1 (GND), J5.B12 (GND), J5.SH (SHIELD), R8.2, R9.2, R10.2, SW1.C, SW1.S1, SW2.6 (C), U3.2 (GND); also elsewhere on the board
unnamed: J5.A5 (CC1), R9.1
unnamed: J5.B5 (CC2), R10.1

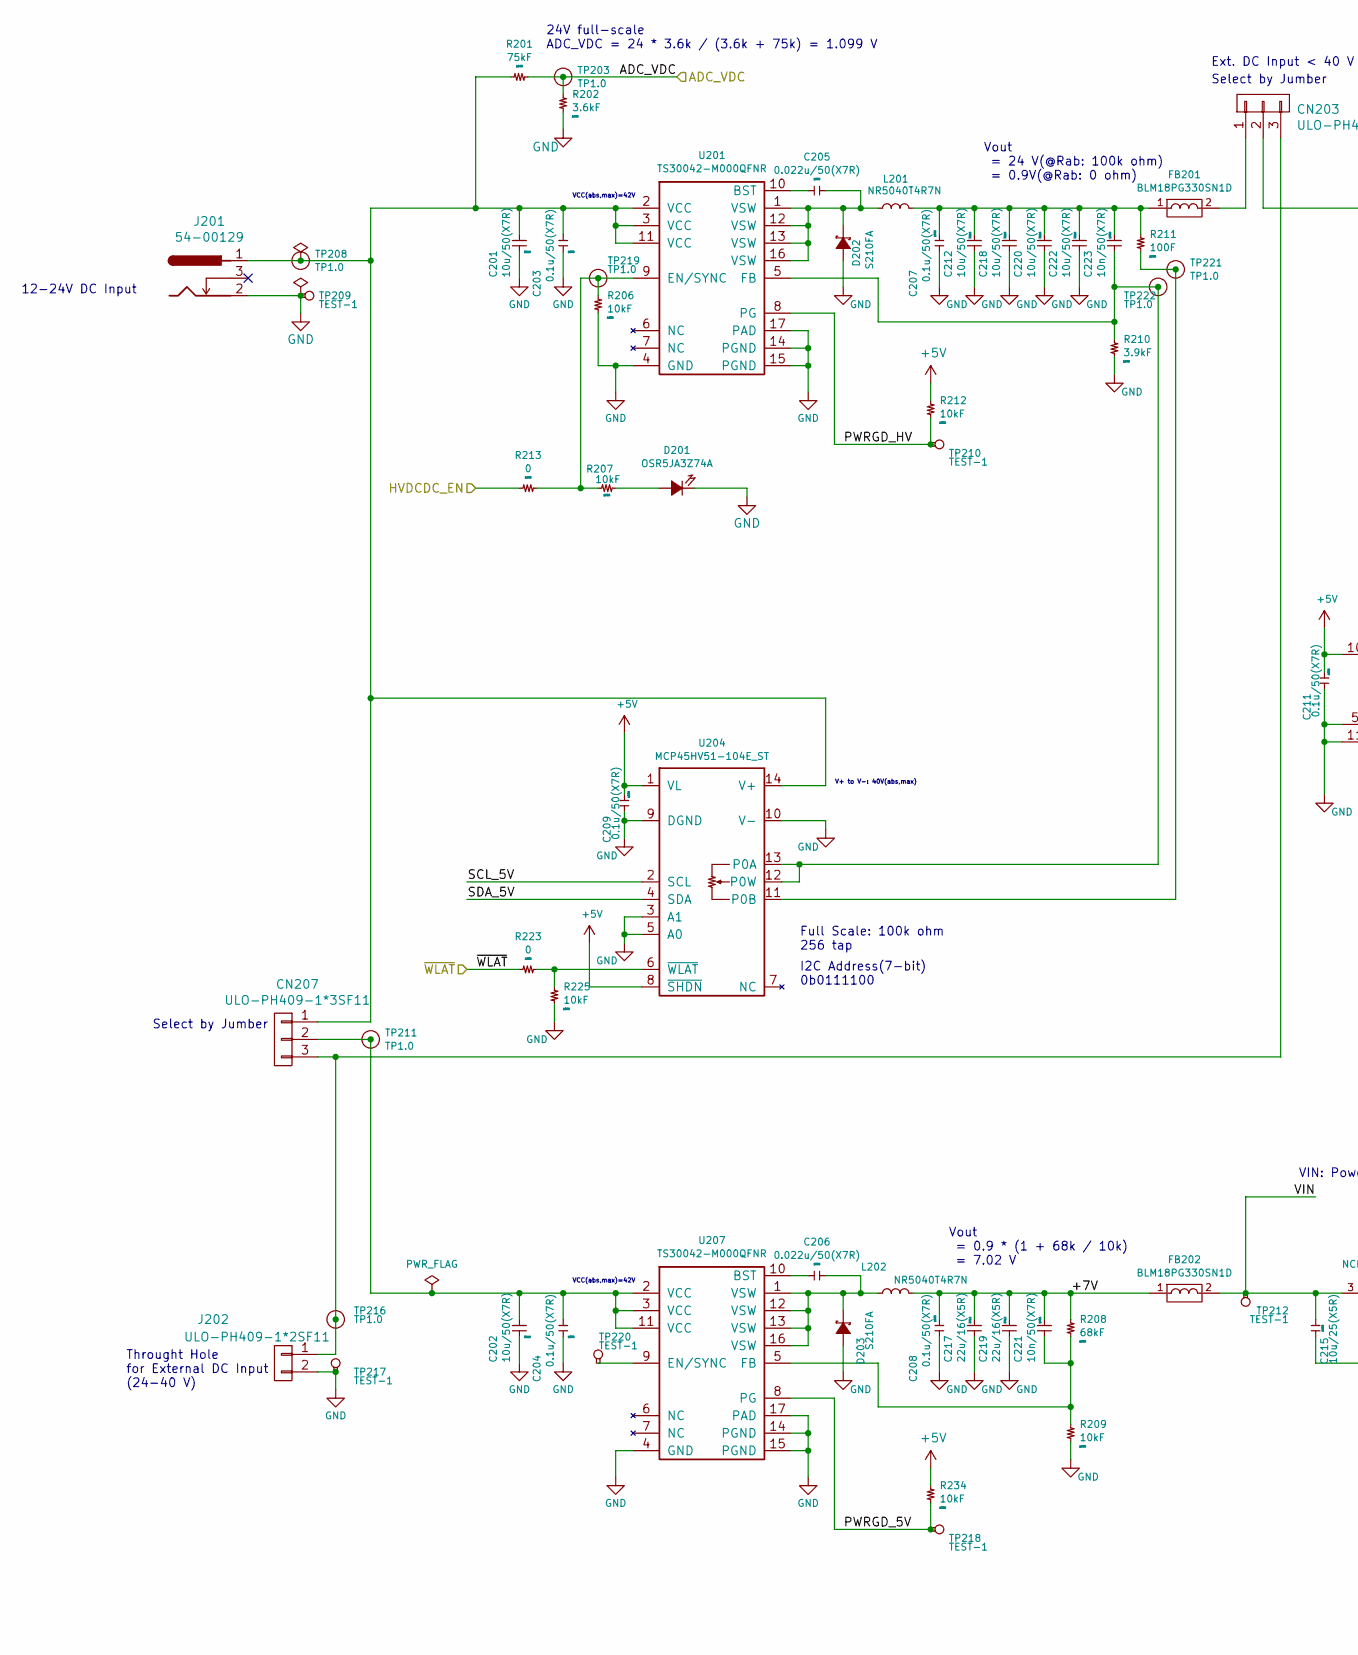
[picture p11: schematic WPT-01-TRANSMITTER-POWER.kicad_sch, part in row 1, column 1]

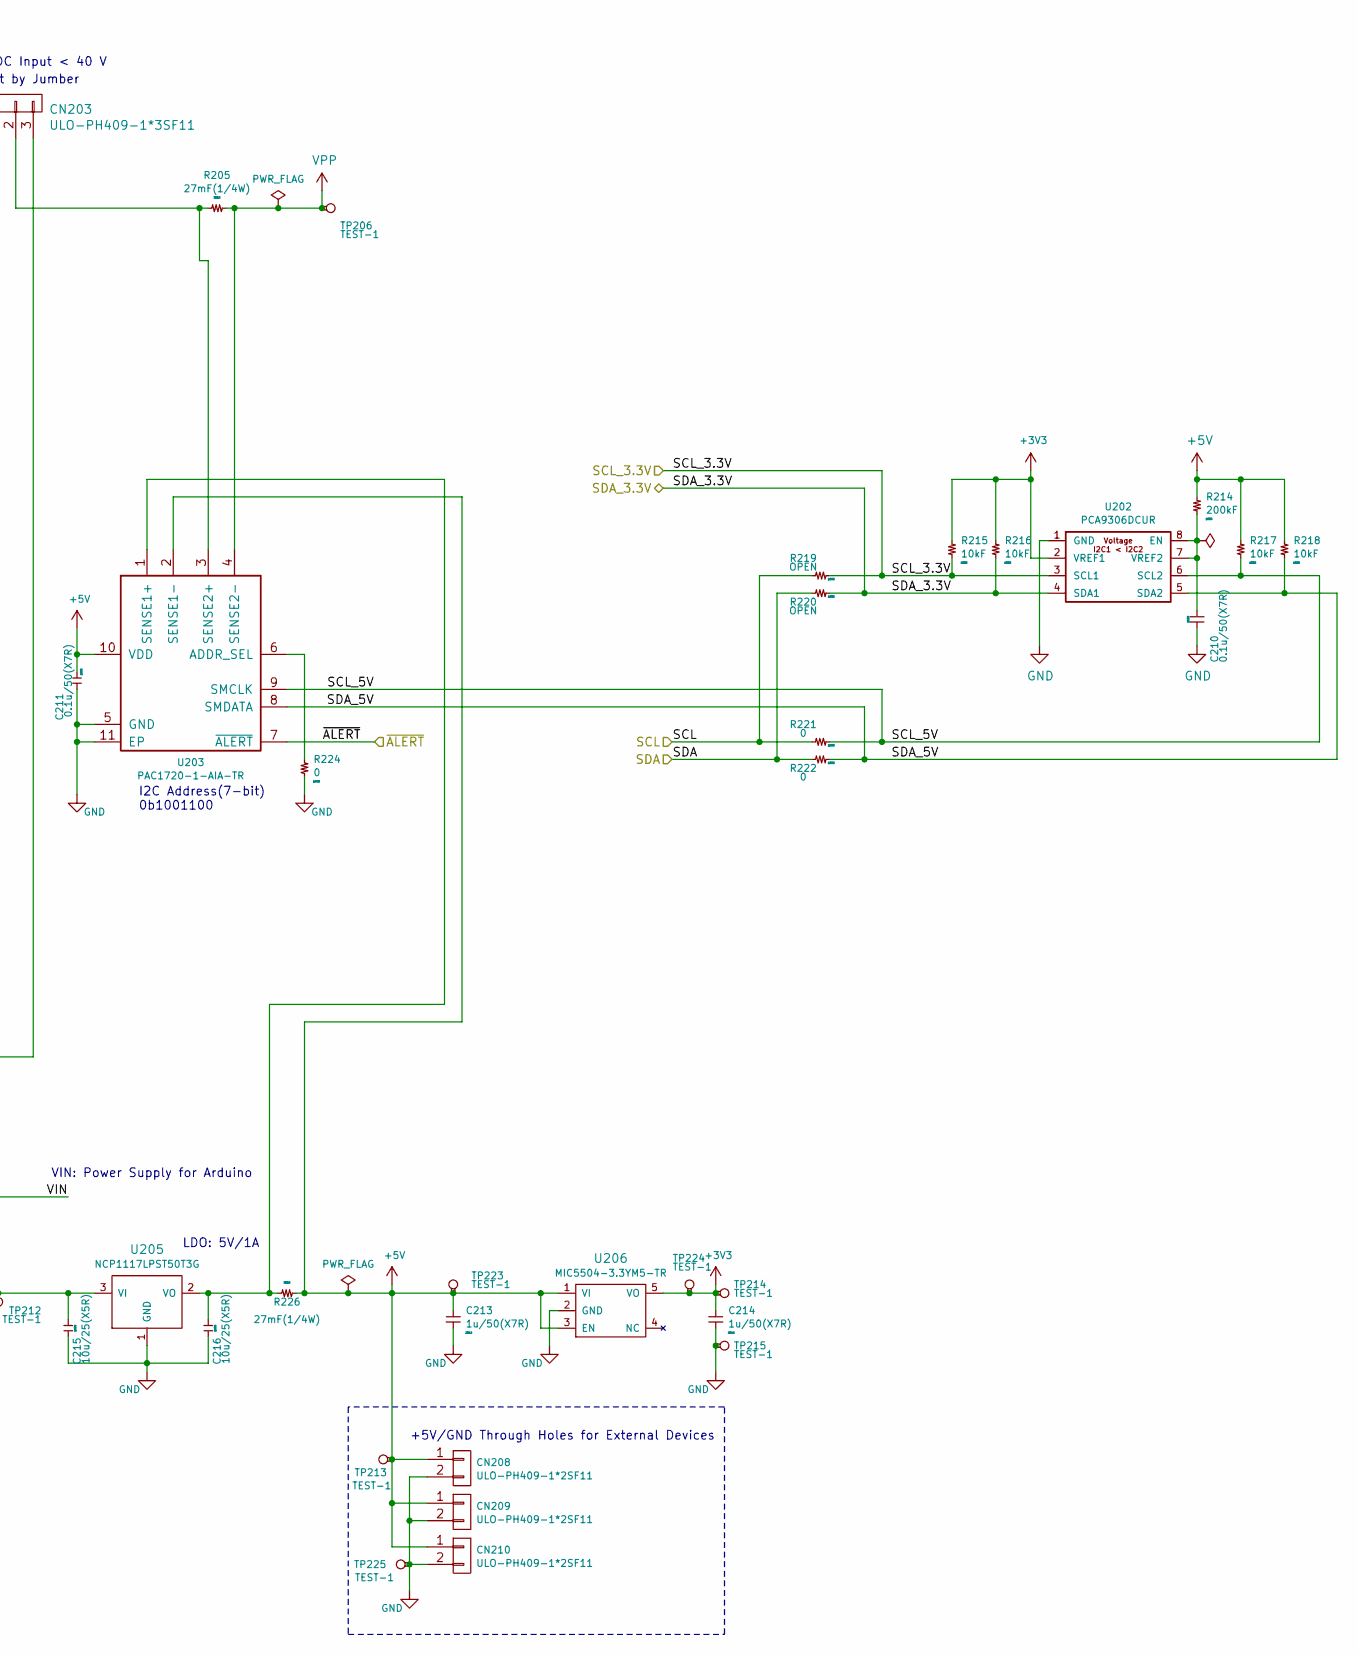
[picture p12: schematic WPT-01-TRANSMITTER-POWER.kicad_sch, part in row 1, column 2]

Parts:
C201, C202, C212, C218, C220, C222: 10u/50(X7R); GRM31; Manufacturer Part Number CL31A106KBHNNNE
C203, C204, C207, C208, C209, C210, C211: 0.1u/50(X7R); GRM15; Manufacturer Part Number GCM155R71H104KE02D
C205, C206: 0.022u/50(X7R); GRM15; Manufacturer Part Number GRM155R71H223KA12D
C213, C214: 1u/50(X7R); GRM21; Manufacturer Part Number CL21B105KBFNNNG
C215, C216: 10u/25(X5R); GRM18; Manufacturer Part Number GRM188R61E106MA73D
C217, C219: 22u/16(X5R); GRM21; Manufacturer Part Number CL21A226MOCLRNC
C221, C223: 10n/50(X7R); GRM15; Manufacturer Part Number CC0402KRX7R9BB103
CN203, CN207: ULO-PH409-1*3SF11; ULO-PH409-1x3SX1; Manufacturer Part Number ULO-PH409-1*3SF11
CN208, CN209, CN210: ULO-PH409-1*2SF11; ULO-PH409-1x2SX1; Manufacturer Part Number ULO-PH409-1x2SX1
D201: OSR5JA3Z74A; LED_D3.0mm; Manufacturer Part Number OSR5JA3Z74A
D202, D203: S210FA; SOD-123FA_OnSemi; Manufacturer Part Number S210FA
FB201, FB202: BLM18PG330SN1D; BLM18; Manufacturer Part Number BLM18PG330SN1D
J201: 54-00129; Manufacturer Part Number 54-00129
J202: ULO-PH409-1*2SF11; ULO-PH409-1x2SX1; Manufacturer Part Number ULO-PH409-1x2SX1
L201: NR5040T4R7N; NR5040
L202: NR5040T4R7N; NR5040; Manufacturer Part Number NR5040T4R7N
R201: 75kF; R_0402; Manufacturer Part Number RC0402FR-0775KL
R202: 3.6kF; R_0402; Manufacturer Part Number RC0402FR-073K6L
R205, R226: 27mF(1/4W); R_1206; Manufacturer Part Number RL1206FR-070R027L
R206, R207, R209, R212, R215, R216, R217, R218, R225, R234: 10kF; R_0402; Manufacturer Part Number RC0402FR-0710KL
R208: 68kF; R_0402; Manufacturer Part Number RC0402FR-0768KL
R210: 3.9kF; R_0402; Manufacturer Part Number RC0402FR-073K9L
R211: 100F; R_0402; Manufacturer Part Number RC0402FR-07100RL
R213, R221, R222, R223, R224: 0; R_0402; Manufacturer Part Number RC0402FR-070RL
R214: 200kF; R_0402; Manufacturer Part Number RC0402FR-07200KL
R219, R220: OPEN; R_0402; Manufacturer Part Number RC0402FR-070RL
TP203, TP208, TP211, TP216, TP219, TP221, TP222: TP1.0; TP_1mm
TP206, TP209, TP210, TP212, TP213, TP214, TP215, TP217, TP218, TP220, TP223, TP224, TP225: TEST-1; PTH_1mm
U201, U207: TS30042-M000QFNR; QFN-16-1EP_3x3mm_Pitch0.5mm_Semtech; Manufacturer Part Number TS30042-M000QFNR
U202: PCA9306DCUR; Texas_S-PDSO-G8; Manufacturer Part Number PCA9306DCUR
U203: PAC1720-1-AIA-TR; DFN-10-1EP_3x3mm_Pitch0.5mm_microchip_9Q; Manufacturer Part Number PAC1720-1-AIA-TR
U204: MCP45HV51-104E_ST; TSSOP-14_4.4x5mm_P0.65mm; Manufacturer Part Number MCP45HV51-104E_ST
U205: NCP1117LPST50T3G; SOT-223-3_TabPin2; Manufacturer Part Number NCP1117LPST50T3G
U206: MIC5504-3.3YM5-TR; microchip_SOT23-5LD-PL-1; Manufacturer Part Number MIC5504-3.3YM5-TR

Connections:
+3V3: C214.1, R215.2, R216.2, TP214.1 (~_1), TP224.1 (~_1), U202.2 (VREF1), U206.5 (VO); also elsewhere on the board
+5V: C209.2, C211.2, C213.1, CN208.1, CN209.1, CN210.1, R212.2, R214.2, R217.2, R218.2, R226.1, R234.2, TP213.1 (~_1), TP223.1 (~_1), U203.2 (SENSE1-), U203.10 (VDD), U204.1 (VL), U204.8 (~SHDN), U206.1 (VI), U206.3 (EN); also elsewhere on the board
/HV_EN_SW: R213.2; also elsewhere on the board
/WPT-01-TRANSMITTER-POWER/+7V: C208.1, C217.1, C219.1, C221.1, FB202.1, L202.2, R208.2
/WPT-01-TRANSMITTER-POWER/ADC_VDC: R201.1, R202.2, TP203.1 (~_1); also elsewhere on the board
/WPT-01-TRANSMITTER-POWER/PWRGD_5V: R234.1, TP218.1 (~_1), U207.8 (PG)
/WPT-01-TRANSMITTER-POWER/PWRGD_HV: R212.1, TP210.1 (~_1), U201.8 (PG)
/WPT-01-TRANSMITTER-POWER/SCL: R219.2, R221.2; also elsewhere on the board
/WPT-01-TRANSMITTER-POWER/SCL_3.3V: R215.1, R219.1, U202.3 (SCL1); also elsewhere on the board
/WPT-01-TRANSMITTER-POWER/SCL_5V: R217.1, R221.1, U202.6 (SCL2), U203.9 (SMCLK), U204.2 (SCL)
/WPT-01-TRANSMITTER-POWER/SDA: R220.2, R222.2; also elsewhere on the board
/WPT-01-TRANSMITTER-POWER/SDA_3.3V: R216.1, R220.1, U202.4 (SDA1); also elsewhere on the board
/WPT-01-TRANSMITTER-POWER/SDA_5V: R218.1, R222.1, U202.5 (SDA2), U203.8 (SMDATA), U204.4 (SDA)
/WPT-01-TRANSMITTER-POWER/VIN: C215.1, FB202.2, TP212.1 (~_1), U205.3 (VI)
/WPT-01-TRANSMITTER-POWER/~ALERT: U203.7 (~ALERT); also elsewhere on the board
/WPT-01-TRANSMITTER-POWER/~WLAT: R223.2; also elsewhere on the board
GND: C201.2, C202.2, C203.2, C204.2, C207.2, C208.2, C209.1, C210.2, C211.1, C212.2, C213.2, C214.2, C215.2, C216.2, C217.2, C218.2, C219.2, C220.2, C222.2, CN208.2, CN209.2, CN210.2, D201.1 (K), D202.2 (A), D203.2 (A), J201.2, J202.2, R202.1, R206.1, R209.1, R210.1, R224.1, R225.1, TP209.1 (~_1), TP215.1 (~_1), TP217.1 (~_1), TP225.1 (~_1), U201.4 (GND), U201.14 (PGND), U201.15 (PGND), U201.17 (PAD), U202.1 (GND), U203.5 (GND), U203.11 (EP), U204.3 (A1), U204.5 (A0), U204.9 (DGND), U204.10 (V-), U205.1 (GND), U206.2 (GND), U207.4 (GND), U207.14 (PGND), U207.15 (PGND), U207.17 (PAD); also elsewhere on the board
unnamed: C207.1, C212.1, C218.1, C220.1, C222.1, C223.1, FB201.1, L201.2, R211.2
unnamed: CN203.1, FB201.2
unnamed: CN203.2, R205.2, U203.3 (SENSE2+)
unnamed: CN203.3, CN207.3, J202.1, TP216.1 (~_1)
unnamed: C201.1, C203.1, CN207.1, J201.1, R201.2, TP208.1 (~_1), U201.2 (VCC), U201.3 (VCC), U201.11 (VCC), U204.14 (V+)
unnamed: C202.1, C204.1, CN207.2, TP211.1 (~_1), U207.2 (VCC), U207.3 (VCC), U207.11 (VCC)
unnamed: D201.2 (A), R207.2
unnamed: C205.2, D202.1 (K), L201.1, U201.1 (VSW), U201.12 (VSW), U201.13 (VSW), U201.16 (VSW)
unnamed: C206.2, D203.1 (K), L202.1, U207.1 (VSW), U207.12 (VSW), U207.13 (VSW), U207.16 (VSW)
unnamed: R206.2, R207.1, R213.1, TP219.1 (~_1), U201.9 (EN/SYNC)
unnamed: TP220.1 (~_1), U207.9 (EN/SYNC)
unnamed: R211.1, TP221.1 (~_1), U204.11 (P0B)
unnamed: C223.2, R210.2, TP222.1 (~_1), U201.5 (FB), U204.12 (P0W), U204.13 (P0A)
unnamed: C205.1, U201.10 (BST)
unnamed: C210.1, R214.1, U202.7 (VREF2), U202.8 (EN)
unnamed: R224.2, U203.6 (ADDR_SEL)
unnamed: C216.1, R226.2, U203.1 (SENSE1+), U205.2 (VO)
unnamed: R223.1, R225.2, U204.6 (~WLAT)
unnamed: C206.1, U207.10 (BST)
unnamed: C221.2, R208.1, R209.2, U207.5 (FB)
VPP: R205.1, TP206.1 (~_1), U203.4 (SENSE2-); also elsewhere on the board

Notes on the sheet:
Throught Hole for External DC Input (24-40 V)
Vout = 24 V(@Rab: 100k ohm) = 0.9V(@Rab: 0 ohm)
24V full-scale ADC_VDC = 24 * 3.6k / (3.6k + 75k) = 1.099 V
Full Scale: 100k ohm 256 tap
VCC(abs,max)=42V
12-24V DC Input
Vout = 0.9 * (1 + 68k / 10k) = 7.02 V
LDO: 5V/1A
Ext. DC Input < 40 V
VIN: Power Supply for Arduino
I2C Address(7-bit) 0b1001100
V+ to V-: 40V(abs,max)
Select by Jumber
+5V/GND Through Holes for External Devices
I2C Address(7-bit) 0b0111100

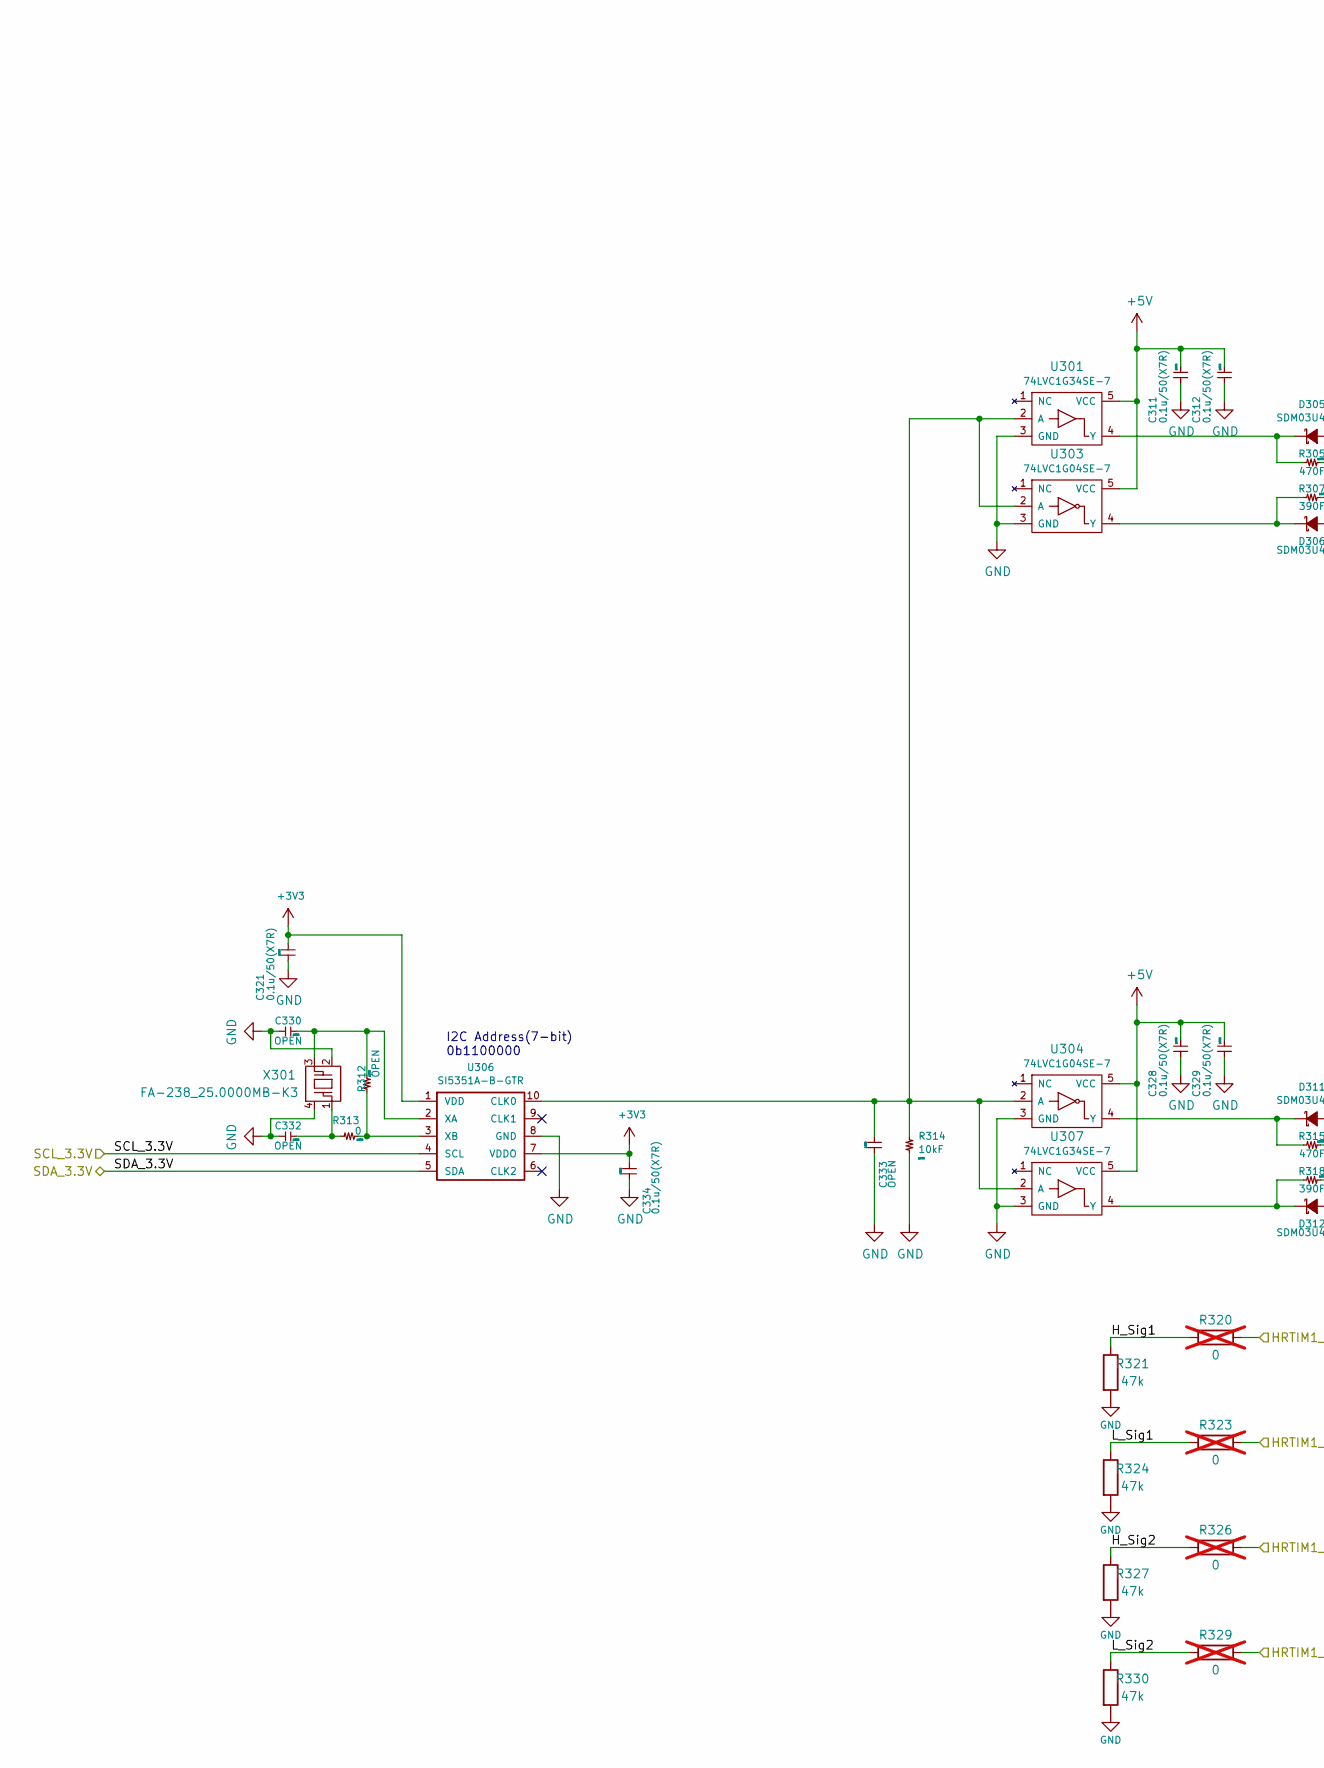
[picture p13: schematic WPT-01-TRANSMITTER-TX.kicad_sch, part in row 1, column 1]

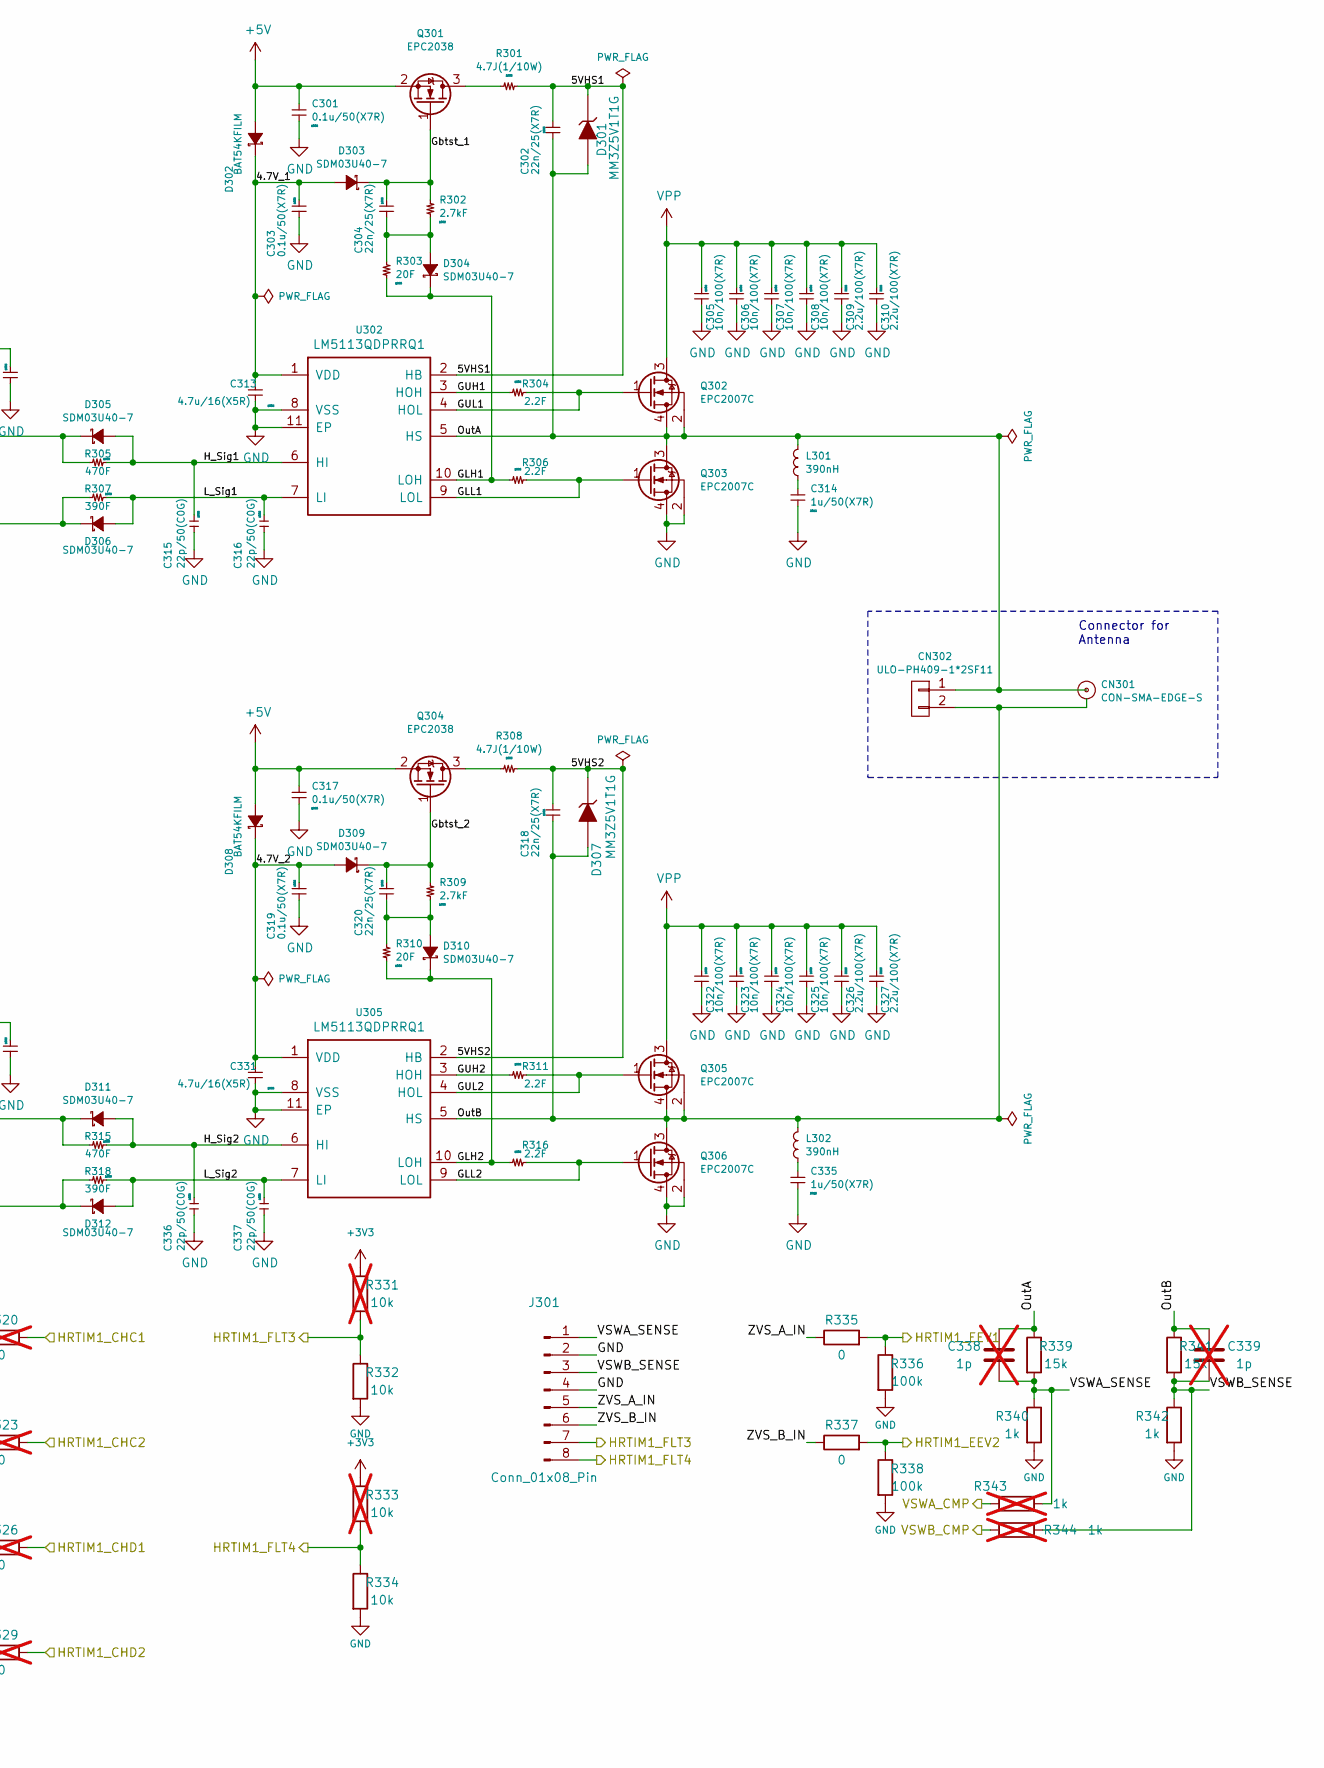
[picture p14: schematic WPT-01-TRANSMITTER-TX.kicad_sch, part in row 1, column 2]

Parts:
C301, C303, C311, C312, C317, C319, C321, C328, C329, C334: 0.1u/50(X7R); GRM15; Manufacturer Part Number GCM155R71H104KE02D
C302, C304, C318, C320: 22n/25(X7R); GRM15; Manufacturer Part Number CC0402KRX7R8BB223
C305, C306, C307, C308, C322, C323, C324, C325: 10n/100(X7R); GRM18; Manufacturer Part Number CL10B103KC8WPNC
C309, C310, C326, C327: 2.2u/100(X7R); GRM32; Manufacturer Part Number CL32B225KCJZW6E
C313, C331: 4.7u/16(X5R); GRM15; Manufacturer Part Number CL05A475MO5NUNC
C314, C335: 1u/50(X7R); GRM21; Manufacturer Part Number CL21B105KBFNNNG
C315, C316, C336, C337: 22p/50(C0G); GRM15; Manufacturer Part Number GCM1555C1H220JA16D
C330, C332: OPEN; GRM15; Manufacturer Part Number GRM15
C333: OPEN; GRM15; Manufacturer Part Number CC0402
C338, C339: 1p; C_0402_1005Metric; not fitted
CN301: CON-SMA-EDGE-S; Manufacturer Part Number CON-SMA-EDGE-S
CN302: ULO-PH409-1*2SF11; ULO-PH409-1x2SX1; Manufacturer Part Number ULO-PH409-1x2SX1
D301, D307: MM3Z5V1T1G; SOD-323; Manufacturer Part Number MM3Z5V1T1G
D302, D308: BAT54KFILM; SOD-523F_STMicroelectronics; Manufacturer Part Number BAT54KFILM
D303, D304, D305, D306, D309, D310, D311, D312: SDM03U40-7; SOD-523F_Diodes; Manufacturer Part Number SDM03U40-7
J301: Conn_01x08_Pin; PinHeader_1x08_P2.54mm_Vertical
L301, L302: 390nH; 2929SQ; Manufacturer Part Number 2929SQ-391JEB
Q301, Q304: EPC2038; Manufacturer Part Number EPC2038
Q302, Q303, Q305, Q306: EPC2007C; Manufacturer Part Number EPC2007C
R301, R308: 4.7J(1/10W); R_0402; Manufacturer Part Number ERJ-2GEJ4R7X
R302, R309: 2.7kF; R_0402; Manufacturer Part Number RC0402FR-072K7L
R303, R310: 20F; R_0402; Manufacturer Part Number RC0402FR-0720RL
R304, R306, R311, R316: 2.2F; R_0402; Manufacturer Part Number RC0402FR-072R2L
R305, R315: 470F; R_0603; Manufacturer Part Number RC0603FR-07470RL
R307, R318: 390F; R_0603; Manufacturer Part Number RC0603FR-07390RL
R312: OPEN; R_0402; Manufacturer Part Number RC0402
R313: 0; R_0402; Manufacturer Part Number RC0402FR-070RL
R314: 10kF; R_0402; Manufacturer Part Number RC0402FR-0710KL
R320, R323, R326, R329: 0; R_0402_1005Metric; not fitted
R321, R324, R327, R330: 47k; R_0402_1005Metric
R331, R333: 10k; R_0402_1005Metric; not fitted
R332, R334: 10k; R_0402_1005Metric
R335, R337: 0; R_0402_1005Metric
R336, R338: 100k; R_0402_1005Metric
R339, R341: 15k; R_0402_1005Metric
R340, R342: 1k; R_0402_1005Metric
R343, R344: 1k; R_0402_1005Metric; not fitted
U301, U307: 74LVC1G34SE-7; SOT-353_SC-70-5_Diodes; Manufacturer Part Number 74LVC1G34SE-7
U302, U305: LM5113QDPRRQ1; Texas_S-PWSON-N10_ThermalVias; Manufacturer Part Number LM5113QDPRRQ1
U303, U304: 74LVC1G04SE-7; SOT-353_SC-70-5_Diodes; Manufacturer Part Number 74LVC1G04SE-7
U306: SI5351A-B-GTR; Siliconlabs_MSOP-10_3x3mm_Pitch0.5mm; Manufacturer Part Number SI5351A-B-GTR
X301: FA-238_25.0000MB-K3; FA-238; Manufacturer Part Number FA-238_25.0000MB-K3

Connections:
+3V3: C321.1, C334.1, R331.1, R333.1, U306.1 (VDD), U306.7 (VDDO); also elsewhere on the board
+5V: C301.1, C311.1, C312.1, C317.1, C328.1, C329.1, D302.2 (A), D308.2 (A), Q301.2 (S), Q304.2 (S), U301.5 (VCC), U303.5 (VCC), U304.5 (VCC), U307.5 (VCC); also elsewhere on the board
/HRTIM1_CHC1: R320.2; also elsewhere on the board
/HRTIM1_CHC2: R323.2; also elsewhere on the board
/HRTIM1_CHD1: R326.2; also elsewhere on the board
/HRTIM1_CHD2: R329.2; also elsewhere on the board
/HRTIM1_EEV1: R335.2, R336.1; also elsewhere on the board
/HRTIM1_EEV2: R337.2, R338.1; also elsewhere on the board
/HRTIM1_FLT3: J301.7, R331.2, R332.1; also elsewhere on the board
/HRTIM1_FLT4: J301.8, R333.2, R334.1; also elsewhere on the board
/VSWA_CMP: R343.1; also elsewhere on the board
/VSWB_CMP: R344.1; also elsewhere on the board
/WPT-01-TRANSMITTER-POWER/SCL_3.3V: U306.4 (SCL); also elsewhere on the board
/WPT-01-TRANSMITTER-POWER/SDA_3.3V: U306.5 (SDA); also elsewhere on the board
/WPT-01-TRANSMITTER-TX/4.7V_1: C303.1, C313.1, D302.1 (C), D303.2 (A), U302.1 (VDD)
/WPT-01-TRANSMITTER-TX/4.7V_2: C319.1, C331.1, D308.1 (C), D309.2 (A), U305.1 (VDD)
/WPT-01-TRANSMITTER-TX/5VHS1: C302.1, D301.1 (K), R301.1, U302.2 (HB)
/WPT-01-TRANSMITTER-TX/5VHS2: C318.1, D307.1 (K), R308.1, U305.2 (HB)
/WPT-01-TRANSMITTER-TX/GLH1: D304.1 (C), R303.1, R306.2, U302.10 (LOH)
/WPT-01-TRANSMITTER-TX/GLH2: D310.1 (C), R310.1, R316.2, U305.10 (LOH)
/WPT-01-TRANSMITTER-TX/GLL1: Q303.1 (G), R306.1, U302.9 (LOL)
/WPT-01-TRANSMITTER-TX/GLL2: Q306.1 (G), R316.1, U305.9 (LOL)
/WPT-01-TRANSMITTER-TX/GUH1: R304.2, U302.3 (HOH)
/WPT-01-TRANSMITTER-TX/GUH2: R311.2, U305.3 (HOH)
/WPT-01-TRANSMITTER-TX/GUL1: Q302.1 (G), R304.1, U302.4 (HOL)
/WPT-01-TRANSMITTER-TX/GUL2: Q305.1 (G), R311.1, U305.4 (HOL)
/WPT-01-TRANSMITTER-TX/Gbtst_1: C304.1, D303.1 (C), Q301.1 (G), R302.2
/WPT-01-TRANSMITTER-TX/Gbtst_2: C320.1, D309.1 (C), Q304.1 (G), R309.2
/WPT-01-TRANSMITTER-TX/H_Sig1: C315.1, D305.2 (A), R305.1, R320.1, R321.1, U302.6 (HI)
/WPT-01-TRANSMITTER-TX/H_Sig2: C336.1, D311.2 (A), R315.1, R326.1, R327.1, U305.6 (HI)
/WPT-01-TRANSMITTER-TX/L_Sig1: C316.1, D306.2 (A), R307.1, R323.1, R324.1, U302.7 (LI)
/WPT-01-TRANSMITTER-TX/L_Sig2: C337.1, D312.2 (A), R318.1, R329.1, R330.1, U305.7 (LI)
/WPT-01-TRANSMITTER-TX/OutA: C302.2, C338.1, CN301.1, CN302.1, D301.2 (A), L301.2, Q302.2 (S), Q302.4 (S), Q303.3 (D), R339.1, U302.5 (HS)
/WPT-01-TRANSMITTER-TX/OutB: C318.2, C339.1, CN301.2, CN302.2, D307.2 (A), L302.2, Q305.2 (S), Q305.4 (S), Q306.3 (D), R341.1, U305.5 (HS)
/WPT-01-TRANSMITTER-TX/VSWA_SENSE: C338.2, J301.1, R339.2, R340.1, R343.2
/WPT-01-TRANSMITTER-TX/VSWB_SENSE: C339.2, J301.3, R341.2, R342.1, R344.2
/WPT-01-TRANSMITTER-TX/ZVS_A_IN: J301.5, R335.1
/WPT-01-TRANSMITTER-TX/ZVS_B_IN: J301.6, R337.1
GND: C301.2, C303.2, C305.2, C306.2, C307.2, C308.2, C309.2, C310.2, C311.2, C312.2, C313.2, C314.2, C315.2, C316.2, C317.2, C319.2, C321.2, C322.2, C323.2, C324.2, C325.2, C326.2, C327.2, C328.2, C329.2, C330.1, C331.2, C332.1, C333.2, C334.2, C335.2, C336.2, C337.2, J301.2, J301.4, Q303.2 (S), Q303.4 (S), Q306.2 (S), Q306.4 (S), R314.1, R321.2, R324.2, R327.2, R330.2, R332.2, R334.2, R336.2, R338.2, R340.2, R342.2, U301.3 (GND), U302.8 (VSS), U302.11 (EP), U303.3 (GND), U304.3 (GND), U305.8 (VSS), U305.11 (EP), U306.8 (GND), U307.3 (GND), X301.2, X301.4; also elsewhere on the board
unnamed: C314.1, L301.1
unnamed: C332.2, R313.2, X301.1
unnamed: C335.1, L302.1
unnamed: C304.2, D304.2 (A), R302.1, R303.2
unnamed: D305.1 (C), R305.2, U301.4 (Y)
unnamed: D306.1 (C), R307.2, U303.4 (Y)
unnamed: C320.2, D310.2 (A), R309.1, R310.2
unnamed: D311.1 (C), R315.2, U304.4 (Y)
unnamed: D312.1 (C), R318.2, U307.4 (Y)
unnamed: Q301.3 (D), R301.2
unnamed: Q304.3 (D), R308.2
unnamed: C333.1, R314.2, U301.2 (A), U303.2 (A), U304.2 (A), U306.10 (CLK0), U307.2 (A)
unnamed: C330.2, R312.2, U306.2 (XA), X301.3
unnamed: R312.1, R313.1, U306.3 (XB)
VPP: C305.1, C306.1, C307.1, C308.1, C309.1, C310.1, C322.1, C323.1, C324.1, C325.1, C326.1, C327.1, Q302.3 (D), Q305.3 (D); also elsewhere on the board

Notes on the sheet:
Connector for Antenna
I2C Address(7-bit) 0b1100000
