SasataniLab/wpt-devkit/hardware/kicad/WPT-TX/WPT-01-TRANSMITTER.kicad_pcb

## KiCad design hardware/kicad/WPT-TX/WPT-01-TRANSMITTER.kicad_pcb (continued)

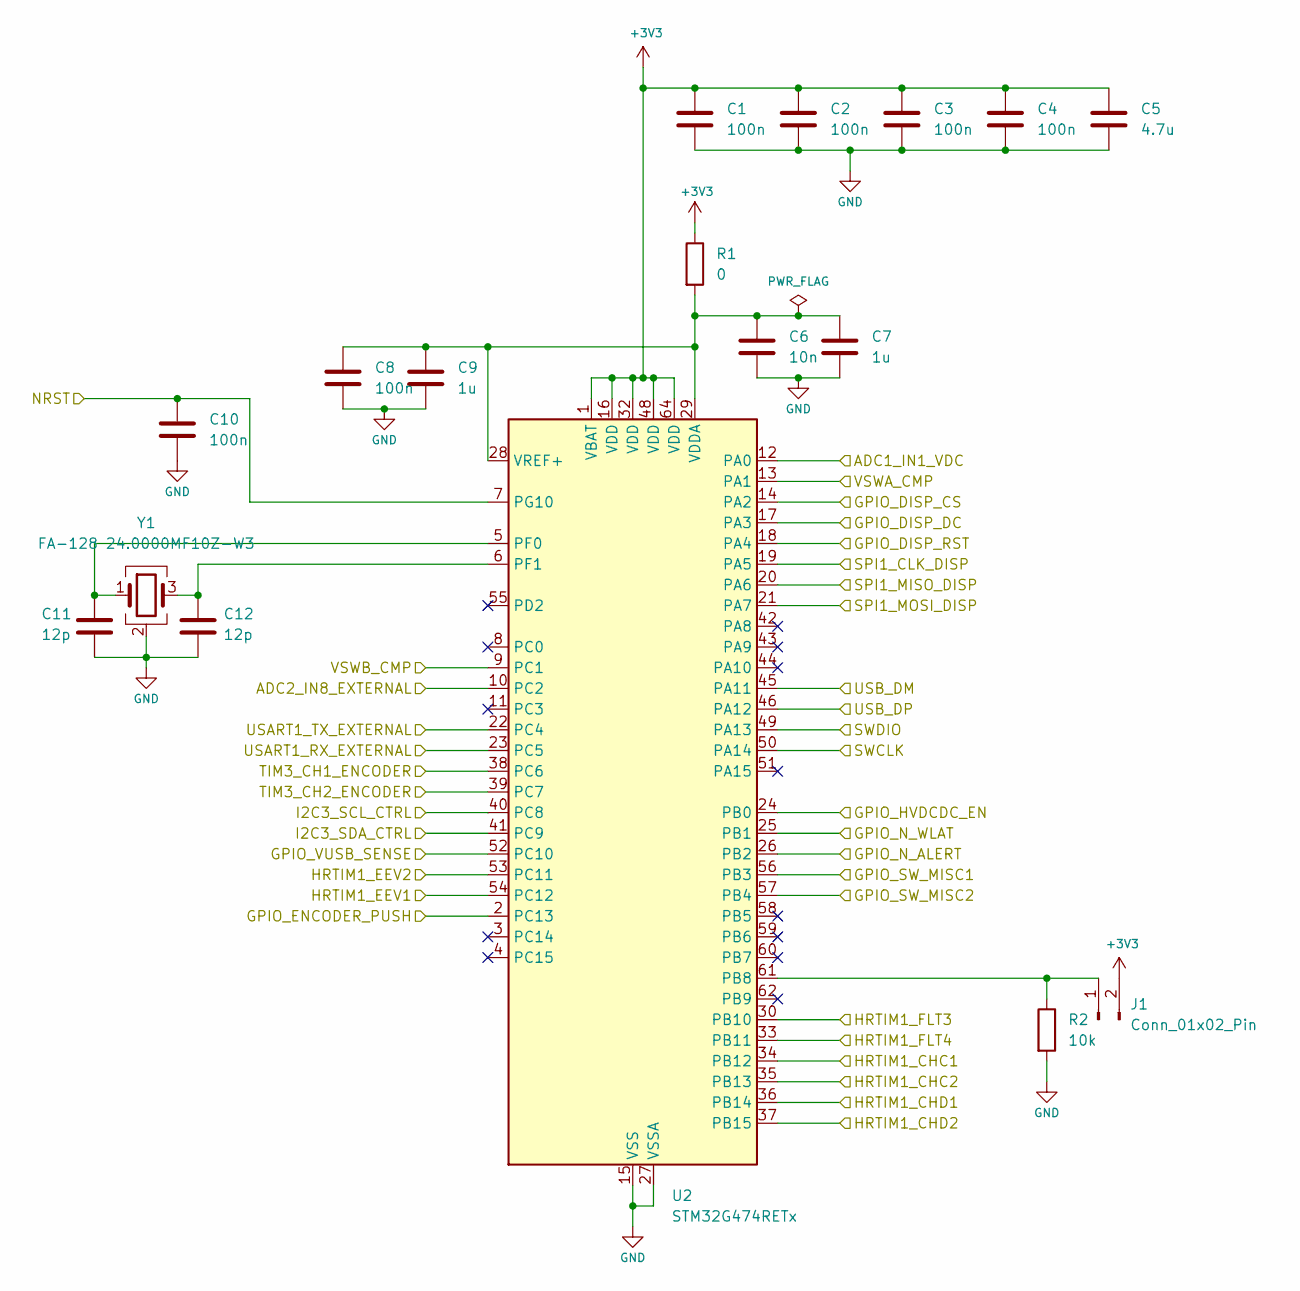
[picture p15: schematic MCU.kicad_sch]

Parts:
C1, C2, C3, C4, C8, C10: 100n; C_0402_1005Metric
C5: 4.7u; C_0402_1005Metric
C6: 10n; C_0402_1005Metric
C7, C9: 1u; C_0402_1005Metric
C11, C12: 12p; C_0402_1005Metric
J1: Conn_01x02_Pin; PinHeader_1x02_P2.54mm_Vertical
R1: 0; R_0402_1005Metric
R2: 10k; R_0402_1005Metric
U2: STM32G474RETx; LQFP-64_10x10mm_P0.5mm
Y1: FA-128 24.0000MF10Z-W3; Crystal_SMD_SeikoEpson_FA128-4Pin_2.0x1.6mm

Connections:
+3V3: C1.1, C2.1, C3.1, C4.1, C5.1, J1.2, R1.1, U2.1 (VBAT), U2.16 (VDD), U2.32 (VDD), U2.48 (VDD), U2.64 (VDD); also elsewhere on the board
/GPIO_VUSB_SENSE: U2.52 (PC10); also elsewhere on the board
/HRTIM1_CHC1: U2.34 (PB12); also elsewhere on the board
/HRTIM1_CHC2: U2.35 (PB13); also elsewhere on the board
/HRTIM1_CHD1: U2.36 (PB14); also elsewhere on the board
/HRTIM1_CHD2: U2.37 (PB15); also elsewhere on the board
/HRTIM1_EEV1: U2.54 (PC12); also elsewhere on the board
/HRTIM1_EEV2: U2.53 (PC11); also elsewhere on the board
/HRTIM1_FLT3: U2.30 (PB10); also elsewhere on the board
/HRTIM1_FLT4: U2.33 (PB11); also elsewhere on the board
/HV_EN_MCU: U2.24 (PB0); also elsewhere on the board
/HV_SW_STATE: U2.57 (PB4); also elsewhere on the board
/MCU/ADC2_IN8_EXTERNAL: U2.10 (PC2); also elsewhere on the board
/MCU/GPIO_DISP_CS: U2.14 (PA2); also elsewhere on the board
/MCU/GPIO_DISP_DC: U2.17 (PA3); also elsewhere on the board
/MCU/GPIO_DISP_RST: U2.18 (PA4); also elsewhere on the board
/MCU/GPIO_ENCODER_PUSH: U2.2 (PC13); also elsewhere on the board
/MCU/GPIO_SW_MISC1: U2.56 (PB3); also elsewhere on the board
/MCU/NRST: C10.1, U2.7 (PG10); also elsewhere on the board
/MCU/SPI1_CLK_DISP: U2.19 (PA5); also elsewhere on the board
/MCU/SPI1_MISO_DISP: U2.20 (PA6); also elsewhere on the board
/MCU/SPI1_MOSI_DISP: U2.21 (PA7); also elsewhere on the board
/MCU/SWCLK: U2.50 (PA14); also elsewhere on the board
/MCU/SWDIO: U2.49 (PA13); also elsewhere on the board
/MCU/TIM3_CH1_ENCODER: U2.38 (PC6); also elsewhere on the board
/MCU/TIM3_CH2_ENCODER: U2.39 (PC7); also elsewhere on the board
/MCU/USART1_RX_EXTERNAL: U2.23 (PC5); also elsewhere on the board
/MCU/USART1_TX_EXTERNAL: U2.22 (PC4); also elsewhere on the board
/USB_DM: U2.45 (PA11); also elsewhere on the board
/USB_DP: U2.46 (PA12); also elsewhere on the board
/VSWA_CMP: U2.13 (PA1); also elsewhere on the board
/VSWB_CMP: U2.9 (PC1); also elsewhere on the board
/WPT-01-TRANSMITTER-POWER/ADC_VDC: U2.12 (PA0); also elsewhere on the board
/WPT-01-TRANSMITTER-POWER/SCL: U2.40 (PC8); also elsewhere on the board
/WPT-01-TRANSMITTER-POWER/SDA: U2.41 (PC9); also elsewhere on the board
/WPT-01-TRANSMITTER-POWER/~ALERT: U2.26 (PB2); also elsewhere on the board
/WPT-01-TRANSMITTER-POWER/~WLAT: U2.25 (PB1); also elsewhere on the board
GND: C1.2, C2.2, C3.2, C4.2, C5.2, C6.2, C7.2, C8.2, C9.2, C10.2, C11.2, C12.2, R2.2, U2.15 (VSS), U2.27 (VSSA), U2.31 (VSS), U2.47 (VSS), U2.63 (VSS), Y1.2 (G), Y1.4 (G); also elsewhere on the board
unnamed: J1.1, R2.1, U2.61 (PB8)
unnamed: C11.1, U2.5 (PF0), Y1.1
unnamed: C12.1, U2.6 (PF1), Y1.3
unnamed: C6.1, C7.1, C8.1, C9.1, R1.2, U2.28 (VREF+), U2.29 (VDDA)

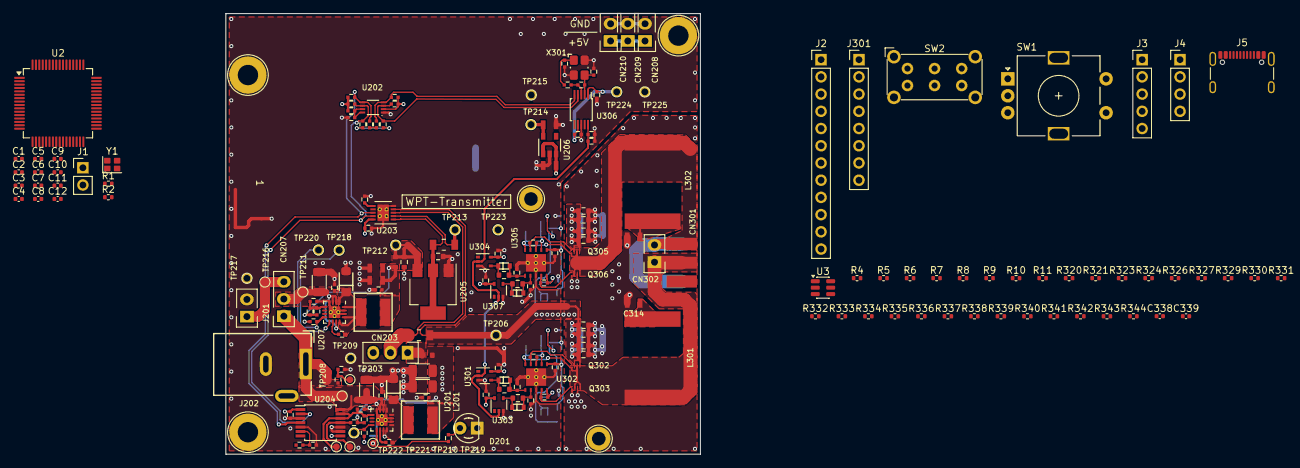
[picture p16: board WPT-01-TRANSMITTER.kicad_pcb from above]

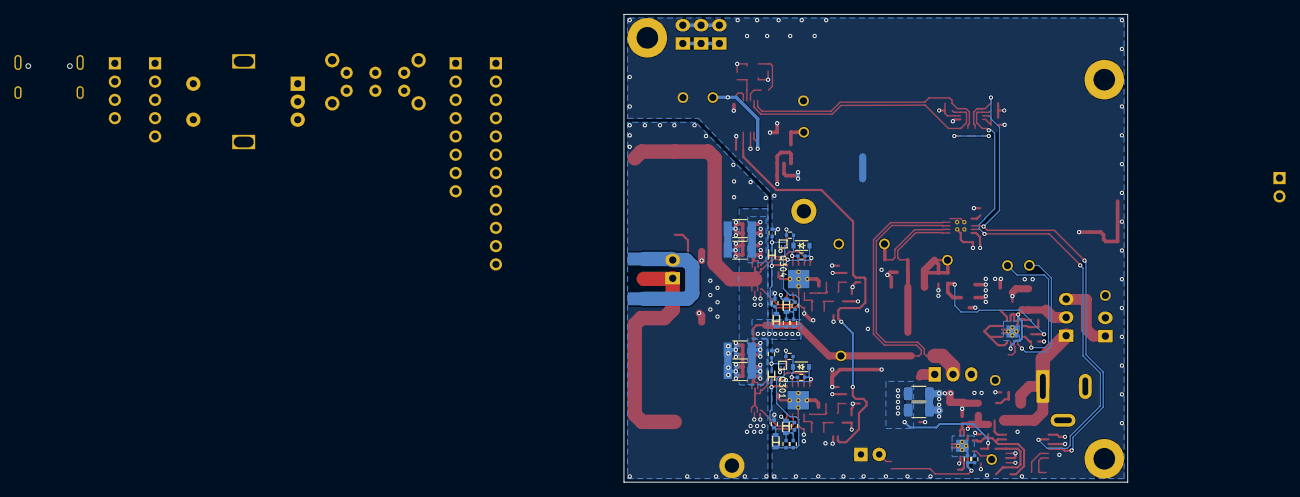
[picture p17: board WPT-01-TRANSMITTER.kicad_pcb from below]

Board: 4 copper layers, 70.0 x 65.0 mm, 230 parts (32 on the bottom side), 114 nets.
