SasataniLab/wpt-devkit/hardware/kicad/WPT-RX/WPT-02-RECEIVER.kicad_pcb

## KiCad design hardware/kicad/WPT-RX/WPT-02-RECEIVER.kicad_pcb (2022-04-14)

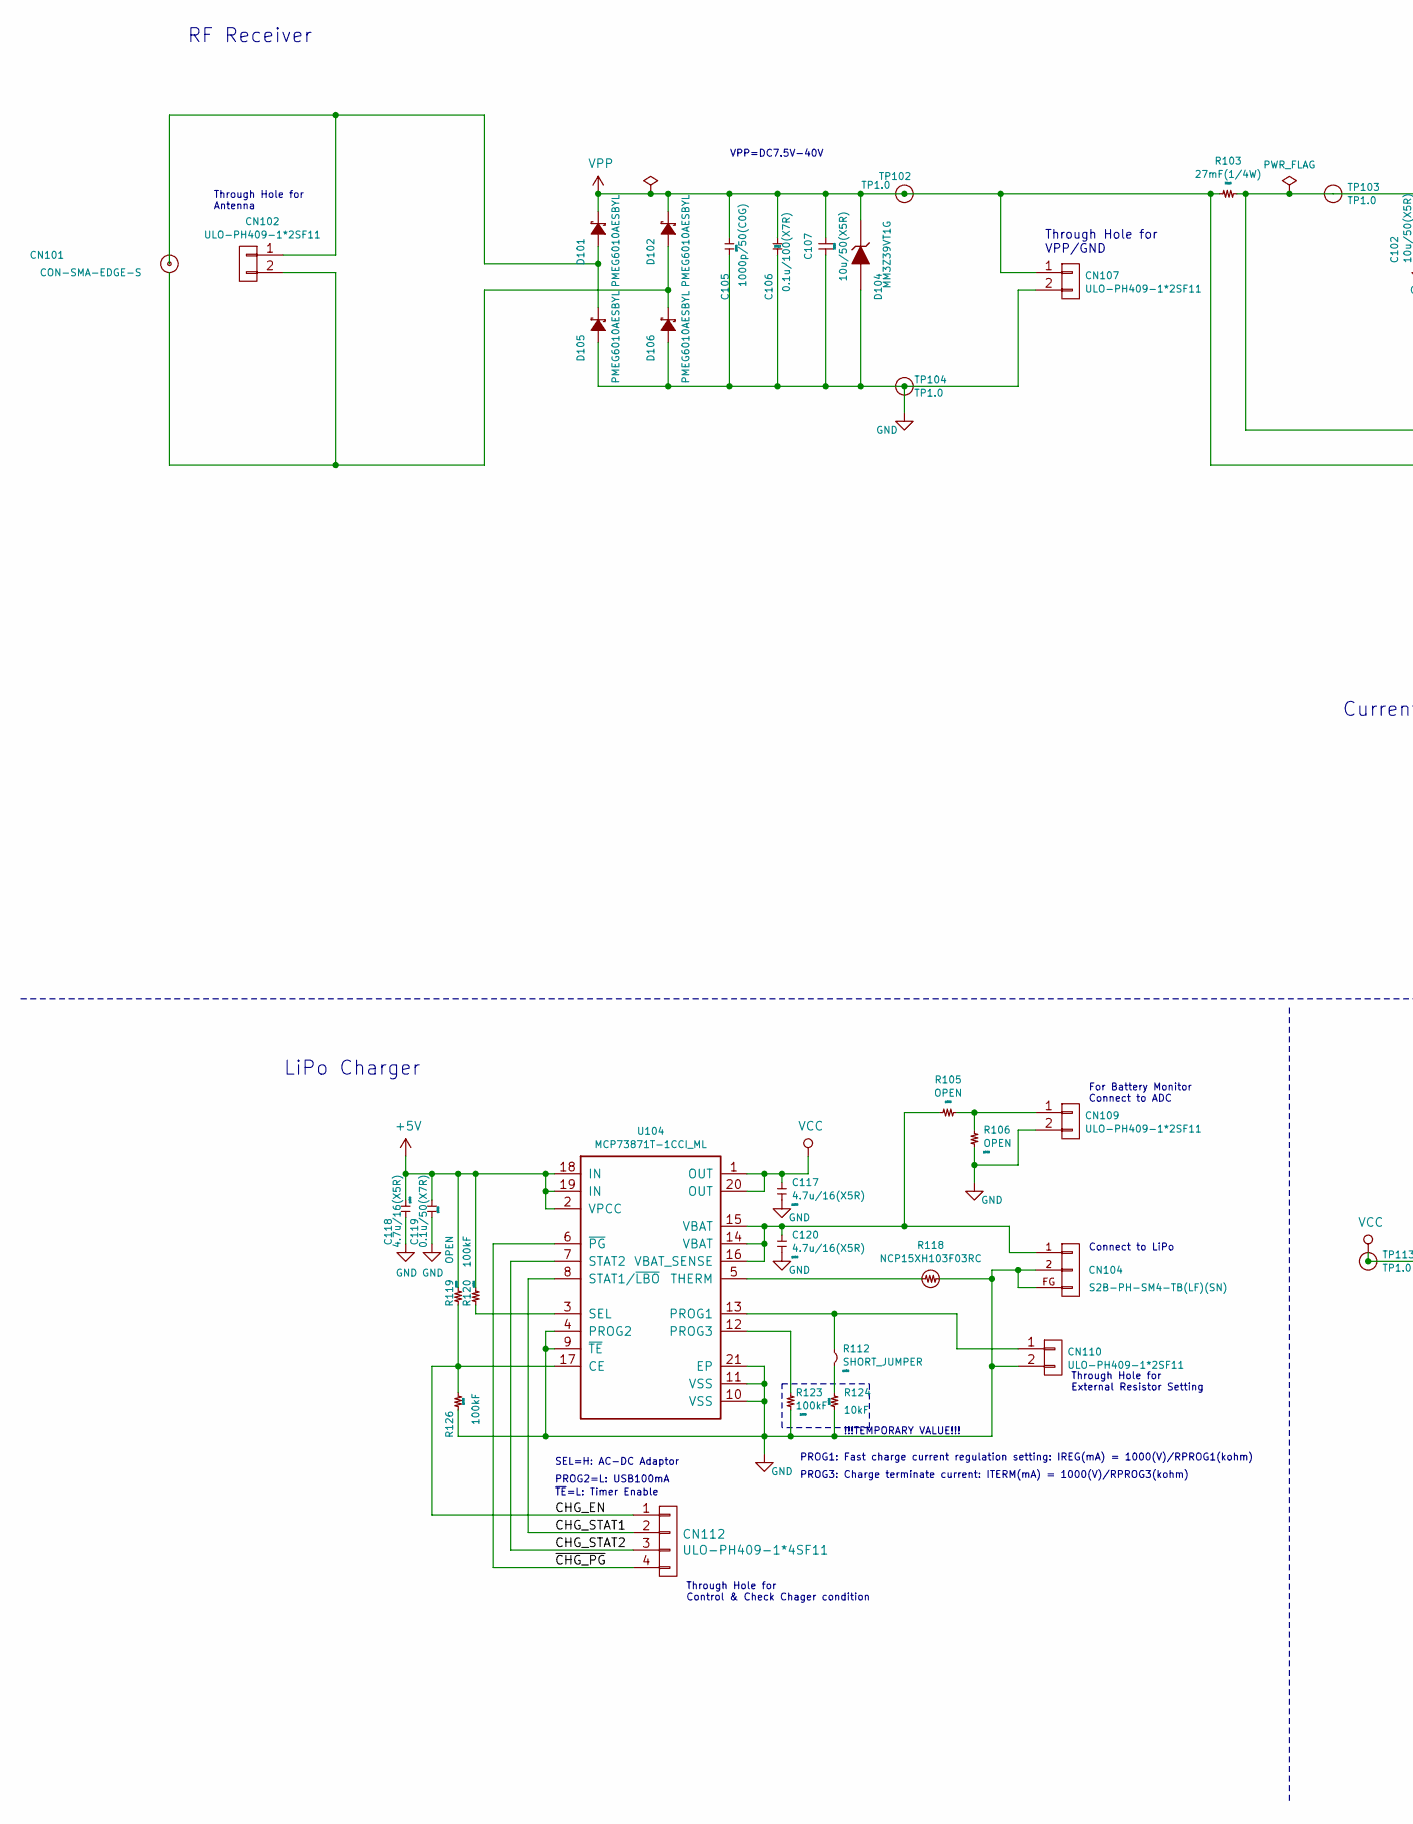
[picture p18: schematic WPT-02-RECEIVER.sch, WPT - Receiver Block, part in row 1, column 1]

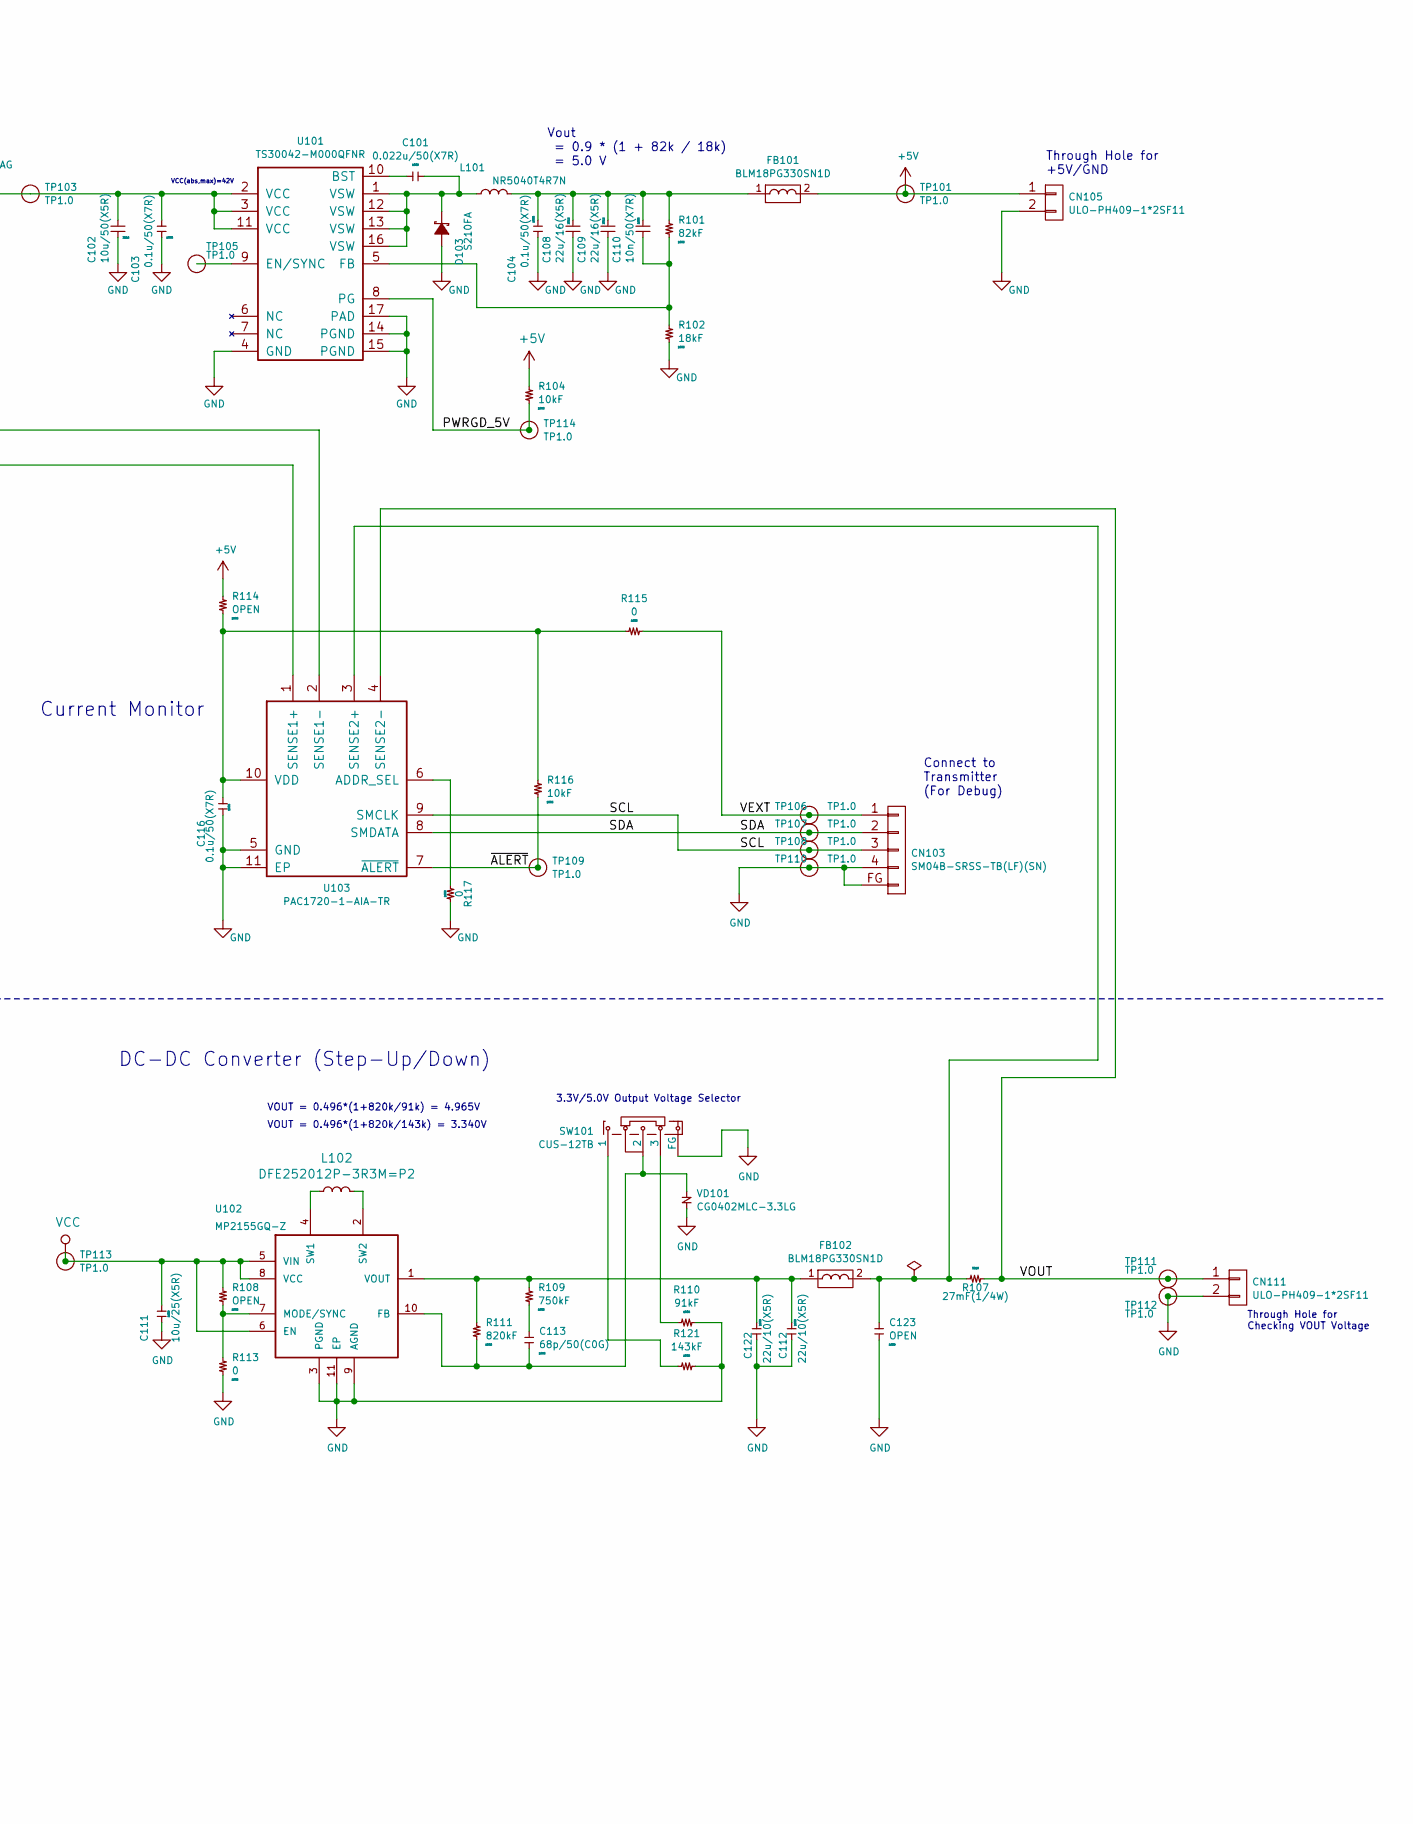
[picture p19: schematic WPT-02-RECEIVER.sch, WPT - Receiver Block, part in row 1, column 2]

Parts:
C101: 0.022u/50(X7R); GRM15; Manufacturer Part Number GRM155R71H223KA12D
C102, C107: 10u/50(X5R); GRM31; Manufacturer Part Number CL31A106KBHNNNE
C103, C104, C116, C119: 0.1u/50(X7R); GRM15; Manufacturer Part Number GCM155R71H104KE02D
C105: 1000p/50(C0G); GRM15; Manufacturer Part Number GRM1555C1H102JA01D
C106: 0.1u/100(X7R); GRM21; Manufacturer Part Number GCM21BR72A104KA37L
C108, C109: 22u/16(X5R); GRM21; Manufacturer Part Number CL21A226MOCLRNC
C110: 10n/50(X7R); GRM15; Manufacturer Part Number CC0402KRX7R9BB103
C111: 10u/25(X5R); GRM18; Manufacturer Part Number GRM188R61E106MA73D
C112, C122: 22u/10(X5R); GRM18; Manufacturer Part Number GRM188R61A226ME15D
C113: 68p/50(C0G); GRM15; Manufacturer Part Number GCM1555C1H680JA16D
C117, C118, C120: 4.7u/16(X5R); GRM18; Manufacturer Part Number GRM188R61C475KAAJD
C123: OPEN; GRM18; Manufacturer Part Number GRM18
CN101: CON-SMA-EDGE-S; Manufacturer Part Number CON-SMA-EDGE-S
CN102, CN105, CN107, CN109, CN110, CN111: ULO-PH409-1*2SF11; ULO-PH409-1x2SX1; Manufacturer Part Number ULO-PH409-1x2SX1
CN103: SM04B-SRSS-TB(LF)(SN); SM04B-SRSS-TB; Manufacturer Part Number SM04B-SRSS-TB(LF)(SN)
CN104: S2B-PH-SM4-TB(LF)(SN); S2B-PH-SM4-TB; Manufacturer Part Number S2B-PH-SM4-TB(LF)(SN)
CN112: ULO-PH409-1*4SF11; ULO-PH409-1x4SX1; Manufacturer Part Number ULO-PH409-1*4SF11
D101, D102, D105, D106: PMEG6010AESBYL; SOD-993_Nexperia; Manufacturer Part Number PMEG6010AESBYL
D103: S210FA; SOD-123FA_OnSemi; Manufacturer Part Number S210FA
D104: MM3Z39VT1G; SOD-323; Manufacturer Part Number MM3Z39VT1G
FB101, FB102: BLM18PG330SN1D; BLM18; Manufacturer Part Number BLM18PG330SN1D
L101: NR5040T4R7N; NR5040; Manufacturer Part Number NR5040T4R7N
L102: DFE252012P-3R3M=P2; DFE252012C; Manufacturer Part Number DFE252012P
R101: 82kF; R_0402; Manufacturer Part Number RC0402FR-0782KL
R102: 18kF; R_0402; Manufacturer Part Number RC0402FR-0718KL
R103, R107: 27mF(1/4W); R_1206; Manufacturer Part Number RL1206FR-070R027L
R104, R116: 10kF; R_0402; Manufacturer Part Number RC0402FR-0710KL
R105, R106, R108, R114: OPEN; R_0402; Manufacturer Part Number RC0402
R109: 750kF; R_0402; Manufacturer Part Number RC0402FR-07750KL
R110: 91kF; R_0402; Manufacturer Part Number RC0402FR-0791KL
R111: 820kF; R_0402; Manufacturer Part Number RC0402FR-07820KL
R112: SHORT_JUMPER; JP_SMD
R113, R115: 0; R_0402; Manufacturer Part Number RC0402FR-070RL
R117: 0; R_0603; Manufacturer Part Number RC0603FR-070RL
R118: NCP15XH103F03RC; NTC_0402; Manufacturer Part Number NCP15XH103F03RC
R119: OPEN; R_0402
R120, R126: 100kF; R_0402; Manufacturer Part Number RC0402FR-07100KL
R121: 143kF; R_0402; Manufacturer Part Number RC0402FR-07143KL
R123: 100kF; R_0603; Manufacturer Part Number RC0603FR-07100KL
R124: 10kF; R_0603; Manufacturer Part Number RC0603FR-0710KL
SW101: CUS-12TB; Manufacturer Part Number CUS-12TB
TP101, TP102, TP103, TP104, TP105, TP106, TP107, TP108, TP109, TP110, TP111, TP112, TP113, TP114: TP1.0; TP_1mm
U101: TS30042-M000QFNR; QFN-16-1EP_3x3mm_Pitch0.5mm_Semtech; Manufacturer Part Number TS30042-M000QFNR
U102: MP2155GQ-Z; DFN-10-1EP_3x3mm_Pitch0.5mm_MPS; Manufacturer Part Number MP2155GQ-Z
U103: PAC1720-1-AIA-TR; DFN-10-1EP_3x3mm_Pitch0.5mm_microchip_9Q; Manufacturer Part Number PAC1720-1-AIA-TR
U104: MCP73871T-1CCI_ML; QFN-20-1EP_4x4mm_Pitch0.5mm_microchip_ML; Manufacturer Part Number MCP73871T-1CCI/ML
VD101: CG0402MLC-3.3LG; CG0402; Manufacturer Part Number CG0402MLC-3.3LG

Connections:
+5V: C118.1, C119.1, CN105.1, FB101.2, R104.2, R114.2, R119.2, R120.2, TP101.1, U104.2 (VPCC), U104.18 (IN), U104.19 (IN)
/CHG_EN: CN112.1, R119.1, R126.2, U104.17 (CE)
/CHG_STAT1: CN112.2, U104.8 (STAT1/~LBO)
/CHG_STAT2: CN112.3, U104.7 (STAT2)
/PWRGD_5V: R104.1, TP114.1, U101.8 (PG)
/SCL: CN103.3, TP108.1, U103.9 (SMCLK)
/SDA: CN103.2, TP107.1, U103.8 (SMDATA)
/VEXT: CN103.1, R115.1, TP106.1
/VOUT: CN111.1, R107.1, TP111.1, U103.4 (SENSE2-)
/~ALERT: R116.1, TP109.1, U103.7 (~ALERT)
/~CHG_PG: CN112.4, U104.6 (~PG)
GND: C102.2, C103.2, C104.2, C105.2, C106.2, C107.2, C108.2, C109.2, C111.2, C112.2, C116.2, C117.2, C118.2, C119.2, C120.2, C122.2, C123.2, CN103.4, CN103.FG, CN104.2, CN104.FG, CN105.2, CN107.2, CN109.2, CN110.2, CN111.2, D103.2 (A), D104.2 (A), D105.2 (A), D106.2 (A), R102.1, R106.1, R110.1, R113.1, R117.1, R118.1, R121.1, R123.1, R124.1, R126.1, SW101.FG, TP104.1, TP110.1, TP112.1, U101.4 (GND), U101.14 (PGND), U101.15 (PGND), U101.17 (PAD), U102.3 (PGND), U102.9 (AGND), U102.11 (EP), U103.5 (GND), U103.11 (EP), U104.4 (PROG2), U104.9 (~TE), U104.10 (VSS), U104.11 (VSS), U104.21 (EP), VD101.1
unnamed: C101.1, U101.10 (BST)
unnamed: C101.2, D103.1 (K), L101.1, U101.1 (VSW), U101.12 (VSW), U101.13 (VSW), U101.16 (VSW)
unnamed: C102.1, C103.1, R103.1, TP103.1, U101.2 (VCC), U101.3 (VCC), U101.11 (VCC), U103.2 (SENSE1-)
unnamed: C104.1, C108.1, C109.1, C110.1, FB101.1, L101.2, R101.2
unnamed: C110.2, R101.1, R102.2, U101.5 (FB)
unnamed: C112.1, C122.1, FB102.1, R109.2, R111.2, U102.1 (VOUT)
unnamed: C113.1, R109.1
unnamed: C113.2, R111.1, SW101.2, U102.10 (FB), VD101.2
unnamed: C116.1, R114.1, R115.2, R116.2, U103.10 (VDD)
unnamed: C120.1, CN104.1, R105.2, U104.14 (VBAT), U104.15 (VBAT), U104.16 (VBAT_SENSE)
unnamed: C123.1, FB102.2, R107.2, U103.3 (SENSE2+)
unnamed: CN101.1, CN102.1, D101.2 (A), D105.1 (K)
unnamed: CN101.2, CN102.2, D102.2 (A), D106.1 (K)
unnamed: CN109.1, R105.1, R106.2
unnamed: CN110.1, R112.2, U104.13 (PROG1)
unnamed: L102.1, U102.4 (SW1)
unnamed: L102.2, U102.2 (SW2)
unnamed: R108.1, R113.2, U102.7 (MODE/SYNC)
unnamed: R110.2, SW101.3
unnamed: R112.1, R124.2
unnamed: R117.2, U103.6 (ADDR_SEL)
unnamed: R118.2, U104.5 (THERM)
unnamed: R120.1, U104.3 (SEL)
unnamed: R121.2, SW101.1
unnamed: R123.2, U104.12 (PROG3)
unnamed: TP105.1, U101.9 (EN/SYNC)
VCC: C111.1, C117.1, R108.2, TP113.1, U102.5 (VIN), U102.6 (EN), U102.8 (VCC), U104.1 (OUT), U104.20 (OUT)
VPP: C105.1, C106.1, C107.1, CN107.1, D101.1 (K), D102.1 (K), D104.1 (K), R103.2, TP102.1, U103.1 (SENSE1+)

Notes on the sheet:
VPP=DC7.5V-40V
PROG2=L: USB100mA
SEL=H: AC-DC Adaptor
~TE~=L: Timer Enable
PROG1: Fast charge current regulation setting: IREG(mA) = 1000(V)/RPROG1(kohm)
PROG3: Charge terminate current: ITERM(mA) = 1000(V)/RPROG3(kohm)
!!!TEMPORARY VALUE!!!
Connect to LiPo
VOUT = 0.496*(1+820k/91k) = 4.965V
VOUT = 0.496*(1+820k/143k) = 3.340V
3.3V/5.0V Output Voltage Selector
Connect to Transmitter (For Debug)
Current Monitor
LiPo Charger
DC-DC Converter (Step-Up/Down)
RF Receiver
VCC(abs,max)=42V
Vout = 0.9 * (1 + 82k / 18k) = 5.0 V
Through Hole for External Resistor Setting
Through Hole for Checking VOUT Voltage
Through Hole for Control & Check Chager condition
Through Hole for Antenna
For Battery Monitor Connect to ADC
Through Hole for +5V/GND
Through Hole for VPP/GND

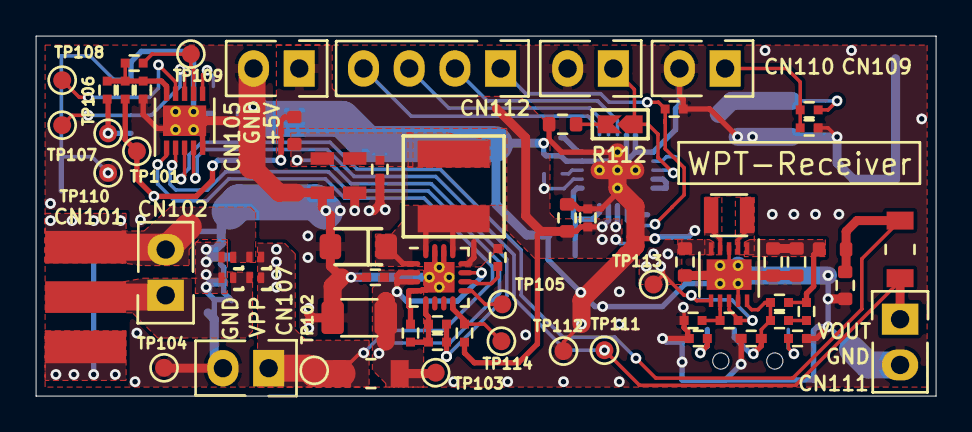
[picture p20: board WPT-02-RECEIVER.kicad_pcb from above]

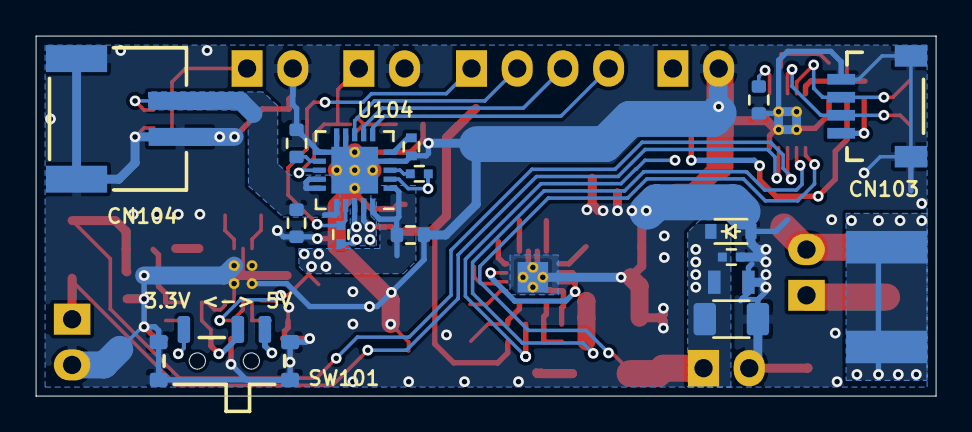
[picture p21: board WPT-02-RECEIVER.kicad_pcb from below]

Board: 4 copper layers, 50.0 x 20.0 mm, 84 parts (15 on the bottom side), 40 nets.
