SasataniLab/wpt-devkit/firmware/STM32_WPTdevkit/STM32_WPTdevkit.ioc

Mcu.UserName=STM32G474RETx
PA0.GPIO_Label=ADC1_IN1_VDC
PA0.Signal=ADC1_IN1
PA1.GPIO_Label=VSWA_CMP
PA1.Signal=COMP1_INP
PA11.Signal=USB_DM
PA12.Signal=USB_DP
PA13.Signal=SYS_JTMS-SWDIO
PA14.Signal=SYS_JTCK-SWCLK
PA2.GPIO_Label=GPIO_DISP_CS
PA2.Signal=GPIO_Output
PA3.GPIO_Label=GPIO_DISP_DC
PA3.Signal=GPIO_Output
PA4.GPIO_Label=GPIO_DISP_RST
PA4.Signal=GPIO_Output
PA5.GPIO_Label=SPI1_CLK_DISP
PA5.Signal=SPI1_SCK
PA6.GPIO_Label=SPI1_MISO_DISP
PA6.Signal=SPI1_MISO
PA7.GPIO_Label=SPI1_MOSI_DISP
PA7.Signal=SPI1_MOSI
PB0.GPIO_Label=GPIO_HVDCDC_EN
PB0.Signal=GPIO_Output
PB1.GPIO_Label=GPIO_N_WLAT
PB1.Signal=GPIO_Output
PB10.GPIO_Label=HRTIM1_FLT3_OCP
PB10.Signal=HRTIM1_FLT3
PB11.GPIO_Label=HRTIM1_FLT4_EXT
PB11.Signal=HRTIM1_FLT4
PB12.GPIO_Label=HRTIM1_CHC1_H_SIG1
PB12.Signal=HRTIM1_CHC1
PB13.GPIO_Label=HRTIM1_CHC2_L_SIG1
PB13.Signal=HRTIM1_CHC2
PB14.GPIO_Label=HRTIM1_CHD1_H_SIG2
PB14.Signal=HRTIM1_CHD1
PB15.GPIO_Label=HRTIM1_CHD2_L_SIG2
PB15.Signal=HRTIM1_CHD2
PB2.GPIO_Label=GPIO_N_ALERT
PB2.Signal=GPIO_Input
PB3.GPIO_Label=GPIO_SW_MISC1
PB3.Signal=GPIO_Input
PB4.GPIO_Label=GPIO_SW_MISC2
PB4.Signal=GPIO_Input
PC1.GPIO_Label=VSWB_CMP
PC1.Signal=COMP3_INP
PC10.GPIO_Label=GPIO_VUSB_SENSE
PC10.Signal=GPIO_Input
PC11.GPIO_Label=HRTIM1_EEV2_ZVS_B
PC11.Signal=HRTIM1_EEV2
PC12.GPIO_Label=HRTIM1_EEV1_ZVS_A
PC12.Signal=HRTIM1_EEV1
PC13.GPIO_Label=GPIO_ENCODER_PUSH
PC13.Signal=GPIO_Input
PC2.GPIO_Label=ADC2_IN8_EXTERNAL
PC2.Signal=ADC2_IN8
PC4.GPIO_Label=USART1_TX_EXTERNAL
PC4.Signal=USART1_TX
PC5.GPIO_Label=USART1_RX_EXTERNAL
PC5.Signal=USART1_RX
PC6.GPIO_Label=TIM3_CH1_ENCODER
PC6.Signal=S_TIM3_CH1
PC7.GPIO_Label=TIM3_CH2_ENCODER
PC7.Signal=S_TIM3_CH2
PC8.GPIO_Label=I2C3_SCL_CTRL
PC8.Signal=I2C3_SCL
PC9.GPIO_Label=I2C3_SDA_CTRL
PC9.Signal=I2C3_SDA
PF0-OSC_IN.Signal=RCC_OSC_IN
PF1-OSC_OUT.Signal=RCC_OSC_OUT
