SasataniLab/wpt-devkit/(commit log)

2022-04-06 added pcb schmatic pdf
2022-04-14 added pcb files
    [Bill of Materials - WPT-02-RECEIVER_2020-03-09.xlsx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]
2023-10-30 add arduino file for mode switching
2024-07-19 Add power on/off commands
2024-08-02 make arduino firmware a installable package
    [Bill of Materials - WPT-02-RECEIVER_2020-03-09.xlsx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]
2026-10-17 add basic parts for stm based board
    [MCU.kicad_sch, WPT-01-TRANSMITTER-POWER.kicad_sch, WPT-01-TRANSMITTER-TX.kicad_sch, WPT-01-TRANSMITTER.csv, WPT-01-TRANSMITTER.kicad_pcb, WPT-01-TRANSMITTER.kicad_sch]
2026-10-17 VBUS detect pin change
    [MCU.kicad_sch]
2026-10-17 add voltage divider for vbus
    [MCU.kicad_sch, WPT-01-TRANSMITTER.kicad_sch]
2026-10-17 USB−C routing
    [WPT-01-TRANSMITTER.kicad_sch]
2026-10-17 USB + interlock
    [WPT-01-TRANSMITTER.kicad_sch]
2026-10-18 sch: USB4105, standard headers, drop R_LEG
    [WPT-01-TRANSMITTER-TX.kicad_sch, WPT-01-TRANSMITTER.kicad_sch]
2026-10-28 sch: DISP_DC rename, VDDA PWR_FLAG, import parts to PCB
    - rename GPIO_DISP_DDC -> GPIO_DISP_DC (sch, pcb net, ioc)
    - add PWR_FLAG on VDDA net (clears ERC power_pin_not_driven)
    - fix J301 Conn_01x08_Pin description to match library
    - pcb: import new footprints from schematic, parked off-board (no placement)
    [MCU.kicad_sch, WPT-01-TRANSMITTER-TX.kicad_sch, WPT-01-TRANSMITTER.kicad_pcb, WPT-01-TRANSMITTER.kicad_sch]
